chenbo2023-pixel/cat_friend/P0产品设计.md

0. 设计范围说明
本设计聚焦P0主线：用户远程手动"云逗猫"的完整流程，按用户操作时间顺序分为5步：页面元素→云台控制方式→逗猫棒/喇叭触发→反馈确认→异常状态。设计原则：走通一条主线，不做全面铺开设计；简单可靠优先于炫技。

当前实施采用分阶段交付：相机识别、拍照和远程开发已通过，首版只实现Android浏览器经WireGuard观看树莓派视频，再接执行器；iPhone视频接入延期。Rust/MJPEG监控代码与本地测试已完成，Pi真实采集、Android显示及部署仍待验收；代码统一放在现有仓库的 `设备端服务/`。监控首版只提供画面和视频状态，以下保留完整P0交互目标，控制按钮上线需以真实执行器验收为前提。
1. 访问安全方案（前置约束，影响页面设计）
- 当前准入采用两条已验证路径：Android、Mac和树莓派通过WireGuard私网连接；iPhone通过云主机Nginx的HTTPS/mTLS入口访问，需要有效客户端证书。云端应用当前监听本机地址，由Nginx转发，后续设备入口按技术方案配置
- 手机侧配置：Android安装WireGuard并导入密钥；iPhone导入客户端证书。详细部署见《技术方案设计》第12、13、18节
- 效果：通过隧道密钥或客户端证书准入，不需要网页账号密码输入页；公网HTTPS入口由mTLS保护，不能将其描述为完全不监听公网
- 页面形态：采用PWA（渐进式网页应用）形式，首次访问后"添加到主屏幕"，之后点图标直接全屏打开，体验接近原生APP，开发成本仍是一套Web代码
2. 页面元素设计
页面核心元素（P0必须）：
- 视频画面区：实时看猫，页面核心区域，占屏幕最大比例
- 连接状态指示：显示当前连接状态（在线/延迟高/安全模式/离线），与"当前模式"指示合并为一行状态条
- 云台方向控制区：上/下/左/右方向按钮 + 归中按钮
- 逗猫棒触发按钮
- 喇叭触发按钮
明确不做（P2/非目标）：登录账号系统、历史录制回放入口、多语言/主题切换、动画特效
布局线框（示意）：
顶部：状态条（如"● 在线-手动模式"）
中部：视频画面（全宽，占比最大）
底部：左侧云台方向按钮（上下左右+归中），右侧逗猫棒/喇叭按钮
3. 云台控制方式设计
P0实现：方向按钮交互
- 上/下/左/右 4个方向按钮 + 1个"归中"按钮
- 交互方式：点一下转动固定步长（如5°/步），不做长按持续转动，指令离散、协议简单
- 归中按钮：一键回到云台默认中位，可复用ESP32侧安全兜底的归中逻辑
预留扩展口子（不在P0实现，但设计上预留接口）：
- "点击画面聚焦追猫"交互暂不实现，但协议层指令格式设计为"目标绝对角度"（如 {pan: 30°, tilt: 15°}）而非"相对步长"，以便未来点击聚焦、P1自主追踪算法（cat_track_node）可直接复用同一套"设置目标角度"指令接口，无需改动协议和节点架构
4. 逗猫棒/喇叭触发设计
P0交互模式：点一下，执行一次固定动作（不做"按住持续/松手停止"或"切换式播放-暂停"）
- 逗猫棒按钮：点一下 → ESP32执行"摆动N次后自动归位"固定动作序列，N值在ESP32侧配置，不暴露给前端
- 喇叭按钮：点一下 → 播放一段固定音效（如"开罐头声"），播完自动停
- 动作执行期间按钮置灰并显示"执行中..."，防止连续点击导致动作重叠
- 选择理由：固定动作、离散指令、行为可预期，避免"忘记松手/断线导致电机持续转动"的风险
5. 反馈确认设计
三层反馈：
- 指令已发送：按钮点击后立即高亮/置灰+显示"执行中..."，纯前端反馈，零延迟，不依赖网络返回
- 指令已被执行：ESP32执行完成后通过WebSocket回传"执行完成"确认帧，前端按钮恢复可点击状态，短暂显示"✓ 已完成"；同时用户可在视频画面中直接看到实际效果（云台转动/逗猫棒摆动），作为自然的第二层反馈
- 超时兜底：指令发出后若3秒内未收到"执行完成"确认，前端显示"响应超时，请检查网络"，按钮恢复可点击，避免卡在"执行中..."状态
技术前提（需在协议设计阶段落地）：自研TCP协议需预留"执行完成确认帧"类型/字段，用于ESP32向上游回传动作执行结果
6. 异常状态设计
四种状态及页面表现：
状态
触发条件
页面表现
在线-正常
网络与链路正常
状态条绿色"● 在线-手动模式"，按钮正常可点
延迟较高
云端-树莓派链路正常但延迟高（弱网）
状态条黄色"⚠️ 网络延迟较高"，按钮仍可点，提示"响应可能较慢"
安全模式
树莓派-ESP32断连，ESP32看门狗生效自动归中
状态条蓝色"🛡️ 安全模式：装置已自动归中待命"，操作按钮置灰（此时ESP32只听自身看门狗逻辑，不接受外部指令）。设计要点：安全模式需与"断线"用不同颜色/图标区分，让用户清楚感知这是设计好的保护行为而非故障，这是产品核心技术亮点的直接体现
离线/断连
手机断网/云主机不可达/WireGuard断连
状态条红色"⚠️ 连接已断开"，视频画面冻结在最后一帧或显示离线占位图，操作按钮全部置灰
恢复连接后：状态条恢复绿色"● 在线-手动模式"，按钮恢复可点。
7. 待技术方案阶段落地的接口约定
- 云台控制指令：绝对角度格式 {pan, tilt}，供手动按钮/未来点击聚焦/P1自主追踪复用
- 执行完成确认帧：ESP32→上游的动作执行结果回传，用于前端"已完成"反馈
- 网络与准入：复用WireGuard及已部署的HTTPS/mTLS入口，云端应用与设备服务的监听范围按实际部署分别确认
