chenbo2023-pixel/cat_friend/周计划.md

# 猫岗哨周计划：真实硬件接入

## 0. 当前状态与实施原则

云台套件、SG40和树莓派4B 4GB已到货，整机组装、舵机ID/中位和实际UART待验收。树莓派已由Trixie换为Raspberry Pi OS Bookworm 64位（Debian 12，aarch64），用户`cat`；OV5647 CSI摄像头识别和拍照已通过。云端Web/PWA已有上线验收记录，下游尚未接入。

当前优先级：摄像头基础验收（完成）→Android网页监控（代码与本地验证完成，实机待验收）→执行器。12V DC5521转XH2.54替换线仍待到货，用户已暂缓微雪环境配置；UART配置、可选官方程序安装及舵机校准均后移。树莓派疑似因笔记本USB供电受休眠影响而断连；建议独立5V/3A或官方5.1V/3A供电，原因与实际电源更换均未确认。

执行器方案仍为树莓派↔驱动板官方GPIO UART接法；中间USB用于Mac烧录、独立测试和调试。USB启动ESP32/AP不等于舵机12V供电或校准验收。先建立出厂JSON基线，再换自研固件和ROS2桥接；各阶段验收后继续。

逐步命令见[操作指南](硬件组装与树莓派配置操作指南.md)，参数与接口见[硬件参考](微雪云台硬件参考.md)，通信决策见[技术方案设计第4节](技术方案设计.md)。

## 1. 摄像头基础验收（已完成）

- `rpicam-hello --list-cameras`已识别OV5647，`rpicam-still`拍照通过。
- 列出的传感器模式：640×480 / 58.92fps、1296×972 / 46.34fps、1920×1080 / 32.81fps、2592×1944 / 15.63fps；这些不是已实现的视频推流帧率。
- 树莓派WireGuard地址`10.0.0.3`，Mac为`10.0.0.4`；已验证局域网外Mac经隧道SSH到Pi。Pi的`wg-quick@wg0`已active/enabled，重启自动恢复仍待正式测试。

已完成边界：摄像头识别与静态照片，不包括手机实时视频。

## 2. Android网页监控（代码与本地验证完成，实机待验收）

- 已实现独立视频链路，不等待执行器或完整微雪环境安装；尚未部署到Pi。
- 当前按用户决定通过SSH前台手动启动，用完按Ctrl-C停止；运行期间持续采集，关闭网页不停止摄像头。本轮不安装或启用视频自启动，保留模板供未来选择。
- 首版只做Android浏览器，通过已有WireGuard访问树莓派提供的网页和视频；云主机使用已有路由转发，无需新增视频代码，仍消耗视频转发带宽。iPhone视频接入延期。
- 设备端代码统一放在现有仓库 `设备端服务/catfriend-video/`，不创建子仓库或子模块。目录及文件职责见[设备端目录说明](设备端服务/README.md)，运行步骤见[视频服务说明](设备端服务/catfriend-video/README.md)；树莓派建议克隆同一仓库并通过Remote SSH开发，克隆与推送认证待执行。
- 已实现采集源适配器→JPEG帧接口→最新帧分发→网页；支持rpicam适配器与Mac变化的测试输入。IP、端口、路径由TOML配置提供，部署与采集实现解耦。
- 初始配置为MJPEG 640×480、5fps、质量75。Mac测试源短时约5fps，实际Pi性能、手机显示帧率和带宽待验收；后续WebRTC/H264未实施。
- 本地通过9项Rust测试、13项网页逻辑测试及HTTP/模拟相机联调；覆盖JPEG分帧、旧帧清除、观看限额与回收、采集退出/超时恢复、网络写入超时和服务退出。格式与Clippy检查通过。

验收（待执行）：Android浏览器通过WireGuard看到实时画面，先核对手机到Pi视频端口的访问；记录实际分辨率、帧率、端到端延迟及断线恢复结果，并验证Mac测试输入与Pi采集可切换、持续运行、重复手动启停和停止后释放相机与端口。视频实现不应启动云台控制程序；视频开机启动不在本轮范围。

## 3. 组装、舵机ID与中位校准（延期，待验收）

- 先保留出厂固件，按官方教程组装；只连接水平舵机时将ID从1改为2，再断电连接倾斜舵机。
- 关闭扭矩锁，调整摄像头水平朝向正前方，分别设置tilt ID 1、pan ID 2的中位。
- 小幅偏离中位后验证归中，记录固件版本和关节响应。
- 官方T=133中的SPD/ACC=0表示最快；TILT机械参数−45°～90°与官方命令范围−30°～90°分别记录。

验收：两个关节可独立控制，归中正确，运动没有结构或排线干涉。

## 4. 树莓派GPIO UART与可选官方程序验证（延期，未执行）

- Bookworm系统基线已确认，保留当前Pi OS，不按旧安排重刷Ubuntu。官方`ugv_rpi`已克隆到`~/ugv_rpi`，版本`3ae9f203f61bfaaf123ee376f78247d007880b0c`，源码审查已完成；依赖安装、UART配置与自启动均未执行。
- 按官方接线图核对UART引脚、电平和共地。40PIN通信与供电分开确认；独立供电时明确5V连接及隔离方式。
- 检查安装脚本中的UART启用、蓝牙串口分配、内核串口控制台/getty及自启动设置，记录实际UART设备、波特率和帧参数。
- 若选择安装官方程序，再处理适用的Pi 4B v4l2.py兼容项，先手动运行，确认需要后配置自启动并重启复验；不将完整官方环境作为手机监控的前置条件。同一时间只有一个控制程序使用UART。
- 官方主页面默认5000端口，JupyterLab默认8888；AccessPopup热点当前可选。

验收（待执行）：实际GPIO UART JSON控制可用，记录接线、设备与串口配置；若启用官方程序，另验其画面与重启恢复，并记录控制服务的停止/停用方式。源码默认参数见硬件参考，不等于实机配置已生效。

## 5. 固件开发准备与执行器验证（后续待执行）

- 出厂JSON基线通过后，若已安装官方控制服务，先停止并停用，再进行Mac烧录或调试。
- 核对USB桥与GPIO UART的电路关系，避免两端并行驱动同一串口信号；必要时断开UART信号连接。
- 阅读ST3215官方例程和SCServo API，确认实际读角、状态、速度单位及目标到达判据。独立Demo可能覆盖出厂固件，先准备对应恢复资料。
- 查明SG40适用的PWM接口、供电和库配置，再做往复摆动验证；不直接把LED或电机接口当PWM舵机接口。

验收：舵机目标下发与实际读角可用，SG40固定动作能完成。

## 6. 正式驱动板自研固件（后续待执行）

- 复用protocol_test.ino的帧解析和心跳判断，适配实际GPIO UART资源；不直接复用S3的Serial/USBSerial双通道配置。
- handleGimbalCmd/handleActuatorTrigger接真实执行器，补实际读角、机械限位与命令合法性检查；最终限位依据装配和固件核对结果。
- 断心跳执行归中停止；新增并定义0x07进/出安全模式状态帧。
- GPIO UART二进制流不混入调试文本。保留当前AA55/XOR帧格式，连续收发和错误场景需实测。

验收：协议命令使硬件动作，确认帧回报实际结果；不再用目标角度回显代替真实读角。

## 7. ROS2与esp32_bridge_node（后续待执行）

- ROS2发行版尚未决定；结合Bookworm和CSI摄像头基线确定运行环境，不在Pi OS直接照抄Ubuntu的Humble apt安装步骤。
- 跑talker/listener，理解topic发布/订阅，再写桥接节点。
- 订阅/gimbal_target、/actuator_trigger，发送串口帧；解析回包并发布/gimbal_ack、/actuator_ack及安全状态，维护双向心跳。
- UART路径、波特率和帧参数可配置。若容器运行，映射实际GPIO UART设备并配置访问权限，不固定/dev/ttyUSB0。
- 若曾安装官方控制程序，确认已停用；重验200ms心跳周期、1秒超时初始值，以及节点终止/恢复、连续发帧、驱动板与树莓派重启。

验收：命令行发{pan, tilt}→云台运动→回报实际角度；停止心跳触发归中及安全状态，恢复心跳后正确恢复。

## 8. 手机控制闭环（后续待执行）

- 复用已连通的树莓派WireGuard（`10.0.0.3`）；补正式重启自动恢复验收，区分服务active/enabled与重启后实测结果。
- 云端补Pi会话、命令转发和完成/状态广播；实现remote_cmd_node与P0直通cmd_mux_node。
- 前端补设备离线、安全模式禁用控制、重连状态恢复等逻辑。

验收：手机点按钮→真实舵机动作→实际角度回到页面；设备断链、归中、恢复状态能正确展示。

## 9. 记录与后续工作

每阶段记录接线、供电、系统/固件版本、UART设备参数和验收结果。发现实际硬件约束时更新方案，早期设想不作为强制实施要求。

先手机监控，再执行器与控制闭环；官方实时视频不能直接等同猫岗哨视频已接入。近期系统、相机和隧道操作记录见《Mac使用文档.md》。喇叭是否另购、型号和接口待记录，投食机构仍为后续阶段。
