chenbo2023-pixel/cat_friend/微雪云台硬件参考.md

# 猫岗哨：微雪二轴云台硬件参考

## 1. 来源、适用范围与当前状态

本文件整合用户提供的 Waveshare《2-Axis Pan-Tilt Camera Module》Wiki、商品参数页、套件配置清单，以及此前提供的组装配置教程。用于后续硬件问答、接线排查、官方功能验证和自研固件开发。

硬件资料主要为用户粘贴内容，参数标注为厂商描述；在线页面、下位机源码与原理图尚未全面核对。官方上位机`ugv_rpi`已克隆到树莓派`~/ugv_rpi`，版本`3ae9f203f61bfaaf123ee376f78247d007880b0c`，源码审查已完成；软件依赖安装、UART配置与自启动均未执行。源码结论不代替接线与实测验收。

当前状态：树莓派4B 4GB现为Raspberry Pi OS Bookworm 64位（Debian 12，aarch64），用户`cat`，此前Trixie已替换。OV5647识别与拍照已通过；整机组装、舵机ID/中位与实际UART仍待验收。12V替换线待到货，微雪环境配置暂缓；Android监控代码和Mac测试已完成，Pi连续采集与手机显示待验收（见《周计划.md》）。下文官方功能描述不代表本项目已验收。

关联文档：

- [设备清单](设备清单.md)：持有设备与状态。
- [硬件组装与树莓派配置操作指南](硬件组装与树莓派配置操作指南.md)：逐步操作与验收。
- [技术方案设计](技术方案设计.md)：猫岗哨架构与协议，第4节已更新为GPIO UART主链路；第14节保留ESP32-S3的USB测试历史。

## 2. 核心设备与职责

| 组成 | 型号/规格 | 作用 |
|---|---|---|
| 上位机 | 用户自备 Raspberry Pi 4B 4GB；产品也支持 Pi 5 | 摄像头采集、官方 Web 程序；后续猫岗哨 ROS2 与远程命令处理 |
| 驱动板 | General Driver for Robots | 集成 ESP32、串口桥、舵机总线、电机驱动、传感器、供电和扩展接口 |
| ESP32 主控 | 模组 ESP32-WROOM-32；芯片 ESP32-D0WD-V3 | 下位机控制、官方 JSON 指令处理；后续运行自研固件 |
| 水平关节 | ST3215 总线舵机，校准后 ID 2 | PAN：正向右、负向左 |
| 倾斜关节 | ST3215 总线舵机，校准后 ID 1 | TILT：正向上、负向下 |
| 摄像头 | RPi Camera (G)，OV5647，500 万像素，标称 160° 超广角 | 配套 CSI 摄像头，通过排线接树莓派 |
| 补光灯 | 配套 LED 聚光灯，PH2.0 接口，功率 <1.5W | 可见光补光；官方通过 IO5 控制亮度 |
| OLED | 0.91inch，I2C | 显示固件、网络、端口和电压等信息 |
| 主电源 | 配套 12V/5A，DC5521 转 XH2.54 线 | 给驱动板和总线舵机供电 |
| 逗猫棒舵机 | 用户另购 SG40，PWM | 逗猫棒摆动，不属于此套件配置清单 |
| 测试开发板 | 用户原有 ESP32-S3 N16R8 | 协议验证与备用，不是正式驱动板的主控 |

摄像头型号与 CSI 接口已由新资料明确，不再作为“CSI 或 USB 待选”记录；安装时仍核对实物与对应排线。

实际相机基线：`rpicam-hello --list-cameras`成功识别OV5647，`rpicam-still`拍照通过。列出的传感器模式为640×480 / 58.92fps、1296×972 / 46.34fps、1920×1080 / 32.81fps、2592×1944 / 15.63fps；不是已达到的推流帧率。Rust/MJPEG代码已实现，初始配置为640×480、5fps，Mac测试输入已验证，Pi真实性能和手机显示尚未验收，WebRTC/H264后续方案未实施。

## 3. 运动与反馈参数

| 项目 | 厂商描述 | 使用时的边界 |
|---|---|---|
| 自由度 | 2 | 水平、倾斜两轴 |
| PAN 机械范围 | −180°～180°，总范围 360° | 不能据此认定支持无限连续旋转；装配和排线也影响可用范围 |
| TILT 机械范围 | −45°～90°，总范围 135° | 官方 T=133/134 指令描述另写 −30°～90° |
| 驱动器旋转速度 | 40rpm | Wiki 的 `40prm` 与商品页 `40rpm` 对照，按 rpm 记录；指令速度字段换算尚未提供 |
| 堵转扭矩 | 30kg·cm @12V | 是堵转参数，不是持续工作扭矩或可直接换算成载重的数值 |
| 编码器 | 12 位、360°磁编码器 | 4096 个编码级，名义分辨率约 0.088°；不等于整机实际定位精度 |
| 重量 | 441g | 厂商产品标称值，未确认是否包含各附件或用户自备树莓派 |

厂商列举可反馈：驱动器状态、关节角度、旋转速度、负载、电压、电流、温度、工作模式。具体读取 API、单位、回包与完成判据仍需查源码。

ST3215 自身完成位置闭环；ESP32 负责目标下发、反馈读取和上层保护。读取到某次角度或收到命令确认，都不能单独证明已经到达目标位置。

官方调试时按对应命令文档的角度范围操作。自研固件的最终机械限位要结合装配实测确认，不因本次资料整理直接改成另一组数值。

## 4. 供电、通信与接口边界

### 4.1 供电

- 整套产品标称 12V，配套电源 12V/5A。
- 驱动板 XH2.54 输入范围标为 DC 7～12.6V，输入直接用于总线舵机和电机供电。该板级范围不代表整套产品在所有输入电压下性能相同。
- 板上 DC-DC 产生 5V，可为树莓派等上位机供电；资料未给出可用输出电流及全部供电路径。
- USB 用于 ESP32 通信与烧录，不能据此把它当作舵机主电源。
- 12V DC5521转XH2.54替换线仍待到货。USB可启动ESP32/AP，不证明舵机12V供电正常或ID/中位校准成功。
- 最近确认的树莓派供电方式为笔记本USB，疑似受笔记本休眠影响而断连；原因未确认。建议独立5V/3A或官方5.1V/3A电源，实际更换未确认。
- GPIO UART与供电方式分别确认。开发期树莓派独立供电时，先核对40PIN中的5V连接并确认隔离方式；如果完整叠接已连接供电引脚，不能默认与独立电源并用。若由驱动板供电，先确认板载5V能力与路径。

### 4.2 三段通信

| 链路 | 官方资料/项目状态 | 需要区分的内容 |
|---|---|---|
| 树莓派 ↔ ESP32 | 当前整机方案采用官方GPIO UART接法 | 先出厂JSON验证，之后继续用UART承载自研协议 |
| Mac ↔ ESP32 | 中间 USB 接口，经 CP2102 串口桥 | 用于烧录、独立串口测试与调试 |
| ESP32 ↔ ST3215 | TTL 舵机总线，按 ID 区分两个舵机 | 与上位机串口是不同链路；不是 PWM 接口 |

选择依据：当前硬件通过40PIN集成树莓派，官方例程使用GPIO UART。早期USB设想不约束实施；先沿用官方接线建立基线，验证稳定后继续用于猫岗哨。

官方 FAQ 解释禁用 Pi 蓝牙是为了 GPIO UART：Pi 4 默认串口分配涉及蓝牙与 mini UART。按安装脚本、系统版本和实际UART分配确认配置；同时启用串口硬件，关闭该UART的内核串口控制台和登录getty占用。

记录实际UART设备路径、波特率及帧参数，不固定使用/dev/ttyUSB0或猜测/dev/ttyAMA编号。官方程序、测试脚本和自研bridge轮流使用控制链路；迁移时停止并停用官方控制自启动服务。Mac烧录或调试前停止树莓派控制，并核对USB桥与GPIO UART是否共用ESP32信号，必要时断开UART信号连接。

已核对的Pi 4源码基线：上述版本`app.py`使用`/dev/serial0`、115200波特率，下发JSON并追加换行；应用启动会发送T=133、X/Y均为0的归零角度命令。因此启动官方应用也可能触发运动，须先确认供电、校准与结构安全。这是源码行为；配置后实际设备映射、接线与UART收发尚未测试。

正式驱动板有 USB 与 LADAR 两个 Type-C 数据口。USB 是 ESP32 通信/下载口，LADAR 是雷达数据口；它们不是 ESP32-S3 上可分别用于协议和 Native USB 调试的两条 ESP32 通道。GPIO UART二进制协议流不混调试文本，安全状态使用计划中的0x07帧；是否能另设独立USB日志通道需核对UART资源和原理图。

### 4.3 板载资源索引

编号对应用户提供的官方接口图；接线仍需对照实物丝印与原理图。

| 编号 | 资源 | 用途 |
|---:|---|---|
| 1 | ESP32-WROOM-32 | 主控，可用 Arduino IDE 开发 |
| 2 | IPEX1 Wi-Fi 接口 | 外接天线 |
| 3 | 激光雷达接口 | 雷达转接 |
| 4 | I2C 外设扩展 | OLED 或其他 I2C 传感器 |
| 5 | EN 按键 | ESP32 复位 |
| 6 | BOOT 按键 | 配合上电/复位进入下载模式 |
| 7 | DC-DC 5V 电路 | 上位机供电 |
| 8 | Type-C LADAR | 雷达数据 |
| 9 | Type-C USB | ESP32 串口通信与固件下载 |
| 10 | XH2.54 输入 | DC 7～12.6V 板级供电 |
| 11 | INA219 | 电压、电流监测 |
| 12 | 电源开关 | 控制外部供电 |
| 13 | ST3215 接口 | 总线舵机 |
| 14 | PH2.0 6P，B 组 | 带编码器电机 |
| 15 | PH2.0 6P，A 组 | 带编码器电机 |
| 16 | PH2.0 2P，A 组 | 无编码器电机输出；此产品用于 LED |
| 17 | PH2.0 2P，B 组 | 无编码器电机输出 |
| 18 | AK09918C | 三轴电子罗盘 |
| 19 | QMI8658 | 六轴运动传感器 |
| 20 | TB6612FNG | 电机驱动 |
| 21 | 总线舵机控制电路 | 多舵机通信与反馈 |
| 22 | 板载 SD 卡槽 | 可用于日志、Wi-Fi 配置；与树莓派系统卡不同 |
| 23 | 40PIN 接口 | 对接上位机 |
| 24 | 40PIN 扩展 | 引出上位机引脚 |
| 25 | CP2102 | 雷达串口转 USB |
| 26 | CP2102 | ESP32 串口转 USB |
| 27 | 自动下载电路 | 正常上传时无需手动操作 EN/BOOT |

该接口表没有给出 PWM 舵机接口、具体 GPIO 或 40PIN 引脚定义。SG40 接法和电源规格仍需查对应驱动板教程/原理图，不能把 LED 或电机接口当作 PWM 舵机接口。

## 5. 官方程序、网络入口与 OLED

### 5.1 两套入口

| 所属设备/功能 | 网络入口 | 地址 |
|---|---|---|
| ESP32 出厂固件 | PT热点（凭据不在本文记录） | `http://192.168.4.1` |
| 树莓派 AccessPopup 热点 | AccessPopup热点（凭据不在本文记录） | 默认 `http://192.168.50.5:5000` |
| 树莓派接家庭 Wi-Fi 或有线网络 | 使用当前局域网地址 | `http://树莓派IP:5000` |
| 树莓派 JupyterLab | 与上位机页面使用相同网络地址 | `http://树莓派IP:8888` |

5000/8888 是本次资料给出的官方默认端口，实际以配置和启动日志为准。AccessPopup 仅在安装并配置后适用；当前自刷 Lite 系统不能假定已经具备这些服务。

当前自刷系统用户为`cat`，本文不记录登录密码或私钥。官方教程按局域网访问描述页面；项目Pi（`10.0.0.3`）与Mac（`10.0.0.4`）WireGuard已连通，局域网外Mac经隧道SSH到Pi已验证。Pi的`wg-quick@wg0`已active/enabled，但重启自动恢复未正式测试；手机视频与控制仍需猫岗哨接入，不能以SSH连通代替验收。

### 5.2 OLED 两种显示阶段

- ESP32 独立运行：开机版本 `PT CAM Version:0.9`，之后显示 AP 热点名、ST 状态/IP、MAC、电源电压。
- 树莓派主程序运行后：E 为网口 IP，W 为无线 IP，F/J 为主页面与 JupyterLab 端口，最后一行显示 AP 状态或 STA 信号强度及运行时间。

因此 OLED 内容不同可能是程序运行阶段不同，不能仅凭显示了网络信息就推断固件异常。

### 5.3 网络管理命令备查

以下仅记录官方命令，不在本次整理中执行：

- AccessPopup 安装菜单：`1` 安装，`5` 添加/编辑已知 Wi-Fi，`9` 退出。
- `sudo accesspopup -a`：切到 AP。
- `sudo accesspopup`：尝试连接已配置的 Wi-Fi。
- `nmcli connection show`：查看连接配置。
- `sudo nmcli connection delete <connection_name>`：删除指定连接；需替换占位符。
- `sudo raspi-config` → Interface Options → SSH：开启 SSH。

切换模式或删除当前连接会改变访问地址或中断连接，重新按 OLED/IP 访问。当前项目保留“先家庭网络和 SSH 验证，AccessPopup 可选”的安排。

## 6. 官方功能及命令速查

官方上位机基于树莓派，可提供实时画面、缩放、拍照、录像、回看、人脸/运动检测、检测后拍照或录像，以及物体/颜色/手势相关功能。具体算法依赖与当前版本行为需查源码，不能据功能名称认定已实现猫追踪。

ESP32 可脱离树莓派完成云台相关控制；摄像头画面与视觉算法依赖上位机。这些官方功能没有自动接入猫岗哨 PWA，也不能据“实时视频”描述认定使用 WebRTC。

### 6.1 下位机 JSON

以下为出厂固件接口，不是猫岗哨 AA55 二进制协议。刷自研固件后是否保留 JSON 接口需另行决定。

| 用途 | 命令示例 | 字段语义/边界 |
|---|---|---|
| 水平舵机改 ID | `{"T":501,"raw":1,"new":2}` | 只连接水平舵机时执行 |
| 关闭扭矩锁 | `{"T":210,"cmd":0}` | 按官方流程用于手动校准 |
| 设置中位 | `{"T":502,"id":1}` / `{"T":502,"id":2}` | 倾斜 1，水平 2 |
| LED | `{"T":132,"IO4":255,"IO5":255}` | 云台灯使用 IO5；0 关，255 最大 |
| 目标角度 | `{"T":133,"X":0,"Y":0,"SPD":0,"ACC":0}` | X：−180～180°，Y：−30～90°；SPD/ACC 为 0 表示最快，不表示停止 |
| 连续控制 | `{"T":134,"X":45,"Y":45,"SX":300,"SY":300}` | X/Y 同上；SX/SY 为对应轴速度，单位待核对 |
| 停止 | `{"T":135}` | 官方描述用于停止运动；实际保持/制动行为待核对 |
| 自稳 | `{"T":137,"s":0,"y":0}` | s=0 关闭，s=1 开启；使用 IMU 调节竖直轴，y 为目标对地夹角 |
| UI 方向控制 | `{"T":141,"X":0,"Y":0,"SPD":300}` | X/Y 为方向值 −1/0/1，不是角度；0 表示该轴停止 |

资料把 IO4/IO5 输出描述为“设置电压”，同时用于 LED 亮度。记录为官方 0～255 控制值；其实际 PWM/驱动实现需查原理图和代码，不能当作任意精密模拟电压输出。

校准归中示例中的 SPD=0、ACC=0 是最快设置。首次验证先用页面小幅控制，并确认结构与排线无干涉；替代速度数值需查官方单位和范围。

### 6.2 树莓派 Web 页面 Enter Command

这些是页面输入框中的应用命令，不应直接当作 Linux shell 命令执行：

```text
base -c {"T":133,"X":0,"Y":0,"SPD":0,"ACC":0}
base --cmd {"T":133,"X":0,"Y":0,"SPD":0,"ACC":0}
base -r on
base -r off
cv -r [90,120,90] [120,255,200]
cv -s red
track -c 0.023
track -f 0.068
track -s 60
track -a 0.4
```

`base` 转发下位机指令或控制反馈叠加显示；`cv` 调整颜色区间/选择；`track` 调整官方追踪比例、速度和加速度比例。颜色空间、速度单位及算法行为需查源码。官方资料另给出的长参数拼写存在单/双连字符不一致，暂保留上述示例供核对。

## 7. 固件恢复与排查

- 官方判据：开机显示 `PT CAM Version:0.9` 就无需按该教程更新；否则检查固件版本。
- 官方恢复工具为 Windows `flash_download_tool_3.9.5.exe`，选择 ESP32、Factory，保持 LockSettings，选 ESP32 的 USB 串口；最高下载波特率标为 921600，完成显示 FINISH。
- 用户开发环境是 Mac，不能直接执行该 exe。后续如在 Mac 恢复，需先取得官方固件包及其烧录地址/配置，再确定工具与完整参数；本文不猜测 flash 偏移。
- 无串口：先确认接编号 9 的 USB、使用数据线，再检查 CP2102 识别。官方设备管理器说明适用于 Windows；Mac 看对应串口设备。
- 卡在 Connecting：官方建议重新插拔后，在上传连接阶段按住 BOOT，按 EN 约一秒后松开 EN，再松开 BOOT。

刷写 ESP32 固件、设置舵机 ID/中位、烧录树莓派系统是不同操作。官方“恢复出厂程序”是否同时重置舵机内部参数，资料没有明确，不能默认它会恢复舵机校准。

## 8. 套件附件清单

以下按用户提供的商品配置记录，数量未逐件开箱核验。树莓派由用户另购，套件不包含树莓派 4B。

| 分组 | 配置 |
|---|---|
| 核心电子件 | General Driver for Robots ×1；ST3215（含线材和螺丝）×2；RPi Camera (G)（含排线）×1；0.91inch OLED ×1；LED 聚光灯 PH2.0 公头 ×1 |
| 结构与安装 | 轴承定位片 ×1；舵机型材底座（2PCS）×1；机器人云台套件（3PCS）×1；轻量化底座（2PCS）×1；平面推力球轴承 ×1；5.3cm 透明螺丝吸盘 ×5；鱼骨导轨及小扳手 ×1；硅胶脚垫 ×8；螺丝包 ×1 |
| 摄像头排线 | 15PIN 异向约 600mm FFC ×1；15PIN 异向黑色约 400mm FFC ×1；Pi5-Camera-Cable-500mm ×1 |
| 其他连接线 | 舵机 3PIN 异向约 300mm ×2；DC5521 转 XH2.54 约 15cm ×1；PH2.0 双头 4PIN 异向约 20cm ×1；双排杜邦线 2×5PIN 同向约 9cm ×1；USB Type-A 转 Type-C 约 1m ×1 |
| 天线 | 2.4G 小辣椒天线 ×1；IPEX1 转 SMA 外螺内孔约 17cm ×1 |
| 电源与工具 | 12V/5A 电源 ×1；螺丝刀 ×1；小十字套筒 ×1；小扳手 ×1；Jetson Nano Adapter (C) ×1 |

鱼骨导轨和 1/4 手拧螺丝用于扩展安装。Pi 5 排线与 Jetson 转接件是兼容附件，不意味着当前 Pi 4B 组装必须全部使用；选择排线时对照接口和触点方向。

## 9. 后续需要补齐的证据

- 实物版本、OLED 固件版本、舵机 ID 与归中验收结果。
- 系统与官方仓库版本已记录；待补GPIO UART实际引脚/设备映射、串口参数及串口控制台/蓝牙配置生效后的实测。
- 原理图与下位机 `json_cmd.h`、舵机控制实现：引脚、速度单位、限位、反馈和完成判据。
- 12V替换线到货与供电验收、树莓派独立电源实际更换、板载5V输出能力、40PIN供电路径、PWM舵机接口和SG40兼容参数。
- CSI识别与实拍已通过；待补手机监控实际视频指标、官方视频传输与接入行为验证，以及WireGuard重启自动恢复验收。
- 喇叭是否另购、型号与接口：该套件配置清单不含喇叭，也不含投食机构。

官方提供下位机程序、ESP32 下载工具、上位机程序、镜像、图纸、STEP 模型和驱动板原理图入口。除已知上位机仓库 https://github.com/waveshareteam/ugv_rpi 外，本次粘贴未包含可核对的下载链接。下载时以实际官方链接及对应说明为准。
