chenbo2023-pixel/cat_friend/技术方案设计.md

《猫岗哨》技术方案设计

0. 说明
本文档记录技术架构设计阶段的讨论结论与选择原因，承接《项目计划.md》第4节的接口约定。讨论顺序：节点划分→通信方式→协议帧格式→仲裁逻辑→安全兜底超时阈值，前面的决策是后面细节设计的前提。本文档随讨论进展持续更新，未确认的部分会在末尾列出，不提前定稿。

1. 云主机角色
当前结论：云主机承担 WireGuard 中心、Nginx/mTLS 入口以及已部署的 Rust 网页和 WebSocket 服务（见第18节）。仲裁、追踪和执行器控制留在树莓派/ESP32；网络层转发与应用层消息转发分别处理。
- 云主机的作用：解决"家里树莓派没有公网IP、手机在外面摸不到树莓派"的问题。树莓派和手机都主动连出去（NAT只挡"外面连进来"，不挡"里面连出去"），双方都连到云主机上，云主机在中间转发数据包，双方看起来像在同一个虚拟局域网里。
- 安全验证方式：WireGuard的密钥准入机制。只有配好密钥的设备（手机、树莓派）才能加入这个虚拟网络，云主机本身不需要额外写校验代码，验证工作由WireGuard软件完成。
- 选择原因：沿用既有 WireGuard 和 mTLS 准入机制；云端提供网页、会话和消息中转，设备侧负责控制和保护，避免把本地执行器逻辑放到云端。
- 说明：当前 WireGuard 星形组网中的设备间 IP 流量经过云主机转发，由 WireGuard 和系统路由处理；WebSocket 会话和命令转发由 Rust 服务处理，二者不能混为一层。
- 手机侧组网方式的平台差异（已确认）：Android手机直接安装WireGuard官方APK（应用商店在部分地区搜不到，改用官方发布页 https://download.wireguard.com/android-client/ 侧载安装）成功接入虚拟网络，方案不变。iOS暂未装成（App Store该地区不可用，自行编译签名遇到设备注册/Team ID/Bundle ID配置等多步障碍），iOS侧备选方案：改为云主机对公网监听HTTPS端口+浏览器直连，鉴权改用mTLS客户端证书（云主机自建CA给设备签发证书，装入iOS系统证书库，TLS握手层完成双向认证，不需要登录密码，未出示合法证书者连接直接被拒、看不到任何内容），效果上等价于把WireGuard的密钥准入机制平移到TLS层，无需在手机上装VPN App。树莓派⇄云主机这段仍使用WireGuard，不受影响。**此方案已实施并验证通过**（iPhone Safari已能通过mTLS访问云主机），具体配置见第13节。

2. 树莓派节点划分（ROS2）
P0阶段3个节点：
- `remote_cmd_node`：维护和云主机的WebSocket连接，接收手机发来的按钮指令，翻译成ROS2消息发给`cmd_mux_node`；同时接收执行完成回报，翻译回WebSocket告知前端。
- `cmd_mux_node`：纯仲裁大脑，只订阅/发布ROS2 topic，不接触任何网络协议细节（不摸WebSocket，不摸串口协议）。
- `esp32_bridge_node`：维护和ESP32的串口连接，把仲裁结果翻译成协议字节流发给ESP32，把ESP32回传的确认帧翻译成ROS2消息发给`cmd_mux_node`。

P1追加：
- `cat_track_node`：猫检测/追踪，运算结果发布到topic，供`cmd_mux_node`订阅。加入后`cmd_mux_node`只需多订阅一路输入，其余节点不受影响。

选择原因：
- 项目定位（产品定义v1.md）明确提出"用ROS2做具身智能实践demo"，练习ROS2的多节点协作模式本身是项目目标之一，因此选择让每条通信边界（手机侧、ESP32侧）各自独立成一个"翻译节点"，而不是把网络协议代码直接写进仲裁节点里。
- 好处：`cmd_mux_node`的输入输出接口统一为ROS2 topic，以后协议细节变更（如串口协议改版）或功能扩展（P1加`cat_track_node`）都不需要改动仲裁节点内部逻辑，避免耦合导致返工。

3. 节点间通信方式
结论：所有节点间通信统一使用ROS2 topic（发布/订阅），不使用service（请求/响应）。

选择原因：
- Service适合处理时间短、可预期的请求（如查配置、触发标定），ROS2社区惯例不建议在处理时间不确定或较长的场景使用service（官方建议改用action）。
- 本项目的指令类通信（云台转动、逗猫棒/喇叭触发）执行完成时间不确定（依赖真实机械动作/ESP32执行进度），如果用service会导致调用方长时间挂起等待，且若在ROS2回调中同步调用service容易造成死锁（同一执行器的回调线程互相等待）。
- 若坚持用service模拟"等待执行完成"，必须用异步调用（future+回调），写法复杂度和"下发指令topic+完成回报topic"基本相当，但多一层future管理负担，故不采用。
- 采用"指令下发topic + 执行完成回报topic"的组合，本质是自己实现了一个轻量版的action语义，足够满足P0的3秒超时兜底需求，且更简单。

具体topic设计：

| 边 | Topic | 方向 | 说明 |
|---|---|---|---|
| remote_cmd_node ⇄ cmd_mux_node | `/remote_cmd` | remote_cmd_node → cmd_mux_node | 手机按钮指令下发 |
| | `/action_completed` | cmd_mux_node → remote_cmd_node | 执行完成回报，供WebSocket告知前端"已完成" |
| cmd_mux_node ⇄ esp32_bridge_node | `/gimbal_target` | cmd_mux_node → esp32_bridge_node | 云台目标角度指令 {pan, tilt} |
| | `/actuator_trigger` | cmd_mux_node → esp32_bridge_node | 逗猫棒/喇叭触发指令，带`action_type: WAND / SPEAKER` |
| | `/gimbal_ack` | esp32_bridge_node → cmd_mux_node | 云台角度执行完成确认 |
| | `/actuator_ack` | esp32_bridge_node → cmd_mux_node | 逗猫棒/喇叭执行完成确认，带`action_type` |

设计要点与原因：
- 云台角度指令与逗猫棒/喇叭触发指令拆成两个独立topic（`/gimbal_target`、`/actuator_trigger`），而非合并成一个通用"控制指令"topic。原因：两者频率和性质差异大——云台角度未来P1追踪时会高频连续发送，逗猫棒/喇叭是低频离散触发，拆开后各自消息结构更干净，互不干扰，`esp32_bridge_node`不需要每次先判断消息类型。
- 逗猫棒和喇叭是两个独立硬件执行器，允许并发执行（不强制串行等待），因此`/actuator_trigger`和`/actuator_ack`都带`action_type`字段，用于区分具体是哪个动作触发/完成，`cmd_mux_node`据此分别管理两个按钮的忙/闲状态，互不阻塞。
- 云台角度指令同样设计了`/gimbal_ack`确认回报，与逗猫棒/喇叭对称，保证前端"点击→置灰→等ack→3秒超时兜底"这套反馈规则（P0产品设计.md第5节）能统一套用在所有按钮上，不需要为云台方向按钮单独设计一套不同的反馈逻辑。

4. ESP32与树莓派物理连接
当前结论（依据到货模组资料及用户确认更新）：树莓派与General Driver for Robots驱动板通过官方GPIO UART接法通信，作为整机主通信链路；驱动板中间USB口用于Mac烧录、独立串口测试与调试，LADAR口用于雷达。

选择原因：
- 该模组支持树莓派通过40PIN接口集成，官方上位机例程使用GPIO UART；先沿用官方接线和配置建立硬件基线，再接入猫岗哨，避免因早期设想额外改接USB。
- 树莓派与驱动板紧邻，有线UART适合这段本地通信；实际串口稳定性、心跳阈值仍需整机验证。
- 原USB方案是在硬件资料不完整时的初步构思，Mac与ESP32-S3的USB协议测试是已完成的历史验证，不约束正式整机的连接方式。
- 物理接法与消息协议分开：官方验证阶段使用出厂固件JSON；之后GPIO UART继续承载猫岗哨AA55二进制帧，ROS2 topic和节点职责沿用既有设计。

实施要求：
- 按对应驱动板版本的官方接线图/原理图确认UART信号、引脚、共地及电平；不从USB测试固件推定GPIO UART对应ESP32的Serial/UART编号。
- 树莓派启用GPIO串口硬件，按官方脚本核对蓝牙串口分配，关闭该通信UART上的登录控制台/getty占用。记录实际UART设备节点、波特率和帧参数；不固定使用/dev/ttyUSB0，也不猜测/dev/ttyAMA或/dev/ttyS编号。
- `esp32_bridge_node`串口路径和通信参数可配置；若ROS2在容器中运行，映射实际UART设备并配置访问权限。
- 官方程序与自研bridge不同时占用控制链路。刷写、Mac调试前先停止树莓派侧控制程序，按原理图确认USB桥与GPIO UART是否共用ESP32串口/信号，必要时断开UART信号；不能默认两端可并行驱动。
- GPIO UART选择不同时决定供电方式。开发期树莓派独立供电时先确认40PIN的5V连接，避免未核对的多路供电；合并供电前确认板载5V能力与路径。
- 正式固件在GPIO UART协议流中只发送协议帧，安全状态通过计划中的0x07帧上报，不混入调试文本；是否有独立USB日志通道留待原理图和UART资源确认。

5. 串口协议帧结构（外层）
结论：所有帧类型（心跳帧、云台指令帧、执行器触发帧、执行完成确认帧、紧急停止帧）共用同一套外层帧结构：
```
帧头 | 长度 | 帧类型 | 数据体 | 校验
```
靠"帧类型"字段区分具体是哪种消息，收发两侧只需写一套"找帧头→读长度→切数据体→算校验"的通用解析框架，不必为每种消息重复实现。

数据体内部（第二层）采用固定struct格式，不做字段级TLV（即不给数据体内部每个字段再加类型标签），字段位置和长度在协议文档中写死约定（如云台指令数据体="2字节pan+2字节tilt"）。

选择原因：
- 外层用类型字段区分消息种类，本质已经是TLV（Type-Length-Value）设计思路，通用性和可扩展性由这一层提供。
- 数据体内部是否需要再套一层字段级TLV（如Protobuf、HTTP header那种可扩展标签结构），取决于协议使用场景：字段级TLV的核心价值是"生成方和解析方可能不同步升级时，老代码能跳过不认识的新字段、不崩溃"。而本项目ESP32固件和树莓派节点代码由同一人同步开发、同步刷新部署，不存在双端版本不同步的问题，因此不需要为此支付额外开销。
- 嵌入式设备资源有限（CPU/内存/传输带宽宝贵），固定struct的数据体解析更简单、字节开销更小，是嵌入式私有二进制协议（如CAN总线应用层协议、Modbus等同类场景）的常见做法，比字段级TLV更贴合当前场景。

6. 串口协议字段格式细节
结论：
- 帧头：固定2字节 `AA 55`，用于收方在字节流中定位帧起点。
- 长度字段：1字节（可表示0~255），描述"帧类型+数据体"合计长度。
- 校验：1字节，对"长度字段+帧类型字段+数据体"逐字节做XOR（按位异或），收方重新计算比对，不一致则丢弃整帧。

选择原因：
- 帧头`AA 55`是嵌入式串口协议的常见约定取值，纯属双方约定，无特殊含义，只要求"不易与正常数据混淆"。
- 长度字段：当前各帧类型数据体最大不超过个位数字节（云台指令4字节、触发指令1字节、确认帧约2字节、心跳/紧急停止帧可为0字节），1字节长度字段已足够覆盖，无需预留更大位宽浪费带宽。
- 当前保留已实现并在ESP32-S3上验证的XOR帧格式，便于复用双端解析代码；GPIO UART接线后的误码、抗干扰和连续收发需补验。XOR不能检测所有错误，心跳/ack超时也不能代替数据完整性校验；本次物理连接调整不另改协议字段，机械限位与命令合法性检查仍需在正式固件落实。

7. 帧类型编号分配
| 编号 | 帧类型 | 方向 |
|---|---|---|
| 0x01 | 心跳帧 | 双向（树莓派⇄ESP32定时互发） |
| 0x02 | 云台指令帧 | 树莓派→ESP32 |
| 0x03 | 执行器触发帧 | 树莓派→ESP32 |
| 0x04 | 云台确认帧 | ESP32→树莓派 |
| 0x05 | 执行器确认帧 | ESP32→树莓派 |
| 0x06 | 紧急停止帧 | 树莓派→ESP32 |

编号从0x01开始（不用0x00，避免与"空/未初始化内存"默认值混淆，嵌入式协议常见做法）。

心跳帧选择双向而非单向的原因：ESP32需要能主动判断"上游（树莓派）是否失联"，才能触发自动归中停止（产品定义v1.md核心安全设计），仅自己发心跳出去不够，必须同时接收对方心跳、维护"最后一次收到对方心跳"的时间戳，超时未收到则触发断线兜底逻辑（具体超时阈值留待第9节安全兜底章节确定）。

8. 各帧类型数据体字段定义
- 心跳帧（0x01）：数据体为空（0字节），仅作为周期性存活信号。
- 云台指令帧（0x02）：数据体=4字节，`[pan: int16小端, 单位度, 范围-180~180] [tilt: int16小端, 单位度, 范围-180~180]`。
- 执行器触发帧（0x03）：数据体=1字节`action_type`（`0x01=WAND`逗猫棒，`0x02=SPEAKER`喇叭）。
- 云台确认帧（0x04）：数据体=5字节，`[状态: 1字节, 0x00=成功/0x01=失败] [pan: int16小端] [tilt: int16小端]`（pan/tilt为执行后实际角度，编码复用云台指令帧）。带实际角度的原因：P0阶段前端可直接从视频画面确认云台位置，价值有限，但P1自主追踪需要据此做闭环判断，提前预留字段避免后续改协议。
- 执行器确认帧（0x05）：数据体=2字节，`action_type`（1字节，复用0x03定义）+ 执行结果状态（1字节，`0x00=成功`、`0x01=失败`）。不带位置信息，因逗猫棒/喇叭动作没有"位置"概念。
- 紧急停止帧（0x06）：归入P1，P0阶段不设计具体数据体字段。原因：审视现有产品文档（产品定义v1.md、P0产品设计.md），P0页面元素只有方向按钮、逗猫棒按钮、喇叭按钮、归中按钮，没有"紧急停止"这个用户可触发的功能点，当前定义该帧类型缺少对应的产品功能支撑。编号0x06先占位保留，避免以后需要时重新分配编号导致其他帧类型编号变动。

云台指令帧编码方案的选择原因：
- 数值范围选-180°~180°：云台机械结构尚未选型，真实极限角度由ESP32侧机械限位保护兜底（产品定义v1.md已确定），协议层无需绑定具体型号的真实边界，取一个覆盖任意常见二轴云台转动范围的通用值即可。
- 精度选整数度：P0交互是"点一下转动固定步长（如5°/步）"（P0产品设计.md第3节），无亚度级精度需求。
- 字节宽度选int16（2字节，±32767）：远超±180°实际需要，比int8更有余量，避免边界溢出风险，成本（多1字节）可忽略。
- 字节序选小端（Little-Endian）：ESP32与树莓派两端CPU均原生小端存储，采用小端可直接用底层内存操作（如memcpy/to_le_bytes）读写，不需要手动做字节序转换。

9. cmd_mux_node仲裁逻辑（P0阶段）
结论：P0阶段`cmd_mux_node`不实现任何"仲裁"分支逻辑，只做单一指令源的直通转发——收到`/remote_cmd`后转成`/gimbal_target`或`/actuator_trigger`发出去；收到`/gimbal_ack`、`/actuator_ack`后转成`/action_completed`发给`remote_cmd_node`。

选择原因：
- `cmd_mux_node`最初定位是"远程/自主指令仲裁"，但仲裁的前提是"有两个以上指令源需要判断该听谁的"。P0阶段唯一指令源是手动指令（`remote_cmd_node`），不存在冲突需要仲裁，此时写任何优先级分支逻辑都是针对不存在场景的假设设计。
- 真正的仲裁规则（如"用户手动操作时自主追踪要不要让路""追踪中用户突然介入的优先级"）要等P1引入`cat_track_node`、真正出现第二个指令源后，才能看到实际冲突场景，据此设计的规则才准确；提前基于假设设计容易与P1实际实现细节不匹配，导致返工（呼应项目计划.md"细节设计依赖架构决策，顺序反了会返工"的原则）。

10. 三层安全兜底的层次划分
链路拓扑：手机⇄云主机⇄树莓派⇄ESP32。三层划分如下：

- 第1层（ESP32心跳看门狗，最终兜底）：ESP32独立判断"树莓派⇄ESP32"这条心跳线是否超时，不依赖、不区分上游具体是哪一段断（手机断、云主机断、树莓派卡死，在ESP32这一侧看到的现象都是"收不到心跳"）。超时即自动归中停止，是保证装置本身不做危险动作的最后一道防线，纯本地判断，独立于网络状态。
- 第2层（树莓派侧检测）：`esp32_bridge_node`/`remote_cmd_node`检测"云主机⇄树莓派"这段连接状态（如WebSocket是否正常），异常时更新状态供上层（前端）展示。
- 第3层（前端侧检测）：手机侧检测"手机⇄云主机"这段连接状态（如WireGuard/WebSocket是否正常、是否能及时收到视频帧/ack），对应展示P0产品设计.md第6节的四种状态条（在线/延迟高/安全模式/离线）。

选择原因：三层各自独立检测自己负责的那一段链路，不依赖其他层告知，使得任意一段断线时，离故障点最近的那一层能最快发现并响应——ESP32能最快归中停止（不受上游状态污染影响响应速度），树莓派能第一时间感知自己与ESP32/云主机的连接状态，前端能第一时间感知自己与云主机的连接状态，三层共同覆盖手机到ESP32的完整链路。

11. 三层安全兜底各层超时阈值

第1层（ESP32心跳看门狗，树莓派⇄ESP32）：
- 心跳发送周期：200ms（双向互发）。
- 超时判定阈值：1秒（心跳周期的5倍）。ESP32连续1秒未收到心跳，判定上游失联，自动归中停止。
- 选择原因：超时阈值需明显大于心跳周期（业界经验3~5倍），避免正常抖动误判。当前保留200ms/1秒作为GPIO UART整机验证的初始值，实际需在树莓派任务负载、真实舵机动作和重启恢复场景下重验；此前USB测试结果不等同于GPIO UART已验收。

第2层（树莓派侧检测，云主机⇄树莓派）：
- 检测方式：复用WebSocket自带的ping/pong机制测RTT，不自研应用层心跳协议（与树莓派⇄ESP32层不同，那层是硬件层面必须自研，这层已有现成成熟机制可直接复用）。
- "延迟较高"阈值：RTT > 300ms。
- "离线"判定：ping间隔5秒，连续3次无响应（约15秒）判定离线。
- 选择原因：链路走公网+WireGuard，延迟波动通常比本地有线串口大，阈值设置相对宽松，避免正常网络波动导致状态频繁跳变；15秒的离线判定时间是"及时发现断线"与"避免网络抖动误判、反复触发重连流程"之间的权衡。

第3层（前端侧检测，手机⇄云主机）：
- 检测方式：与第2层同款机制——WebSocket ping/pong测RTT，阈值同样为"RTT > 300ms判定延迟较高""5秒间隔连续3次无响应（约15秒）判定离线"，不单独另定新数字。
- 状态来源：前端展示的状态是"手机自己到云主机的连接检测结果"与"树莓派转发过来的下游状态（如ESP32是否已触发看门狗保护）"两者合并得出，非前端单独测得——例如"安全模式"这个状态，前端自己无法测出，必须依赖树莓派主动上报"ESP32心跳超时已触发看门狗保护"。
- 选择原因：第2层和第3层检测的是同一条链路（手机⇄云主机⇄树莓派）的两端，若各自定义不同阈值，容易在两端观测到不一致的网络状况时产生矛盾的状态判断；复用同一套机制和阈值，保证两端标准统一，也节省单独设计一套新机制的成本。

四种状态合并优先级（P0产品设计.md第6节的四种状态条，从高到低）：
1. 离线/断连（手机ping云主机连续15秒无响应）——最高优先级，一旦离线，前端收不到任何下游信息，其他状态判断均无意义。
2. 安全模式（树莓派上报"ESP32心跳超时已触发看门狗保护"）——次高，即使手机⇄云主机链路本身正常，只要下游已进入保护状态就必须显示，确保用户能明确感知"装置已自我保护"而非误认为正常工作中，这是产品核心安全亮点的直接体现。
3. 延迟较高（手机⇄云主机 RTT > 300ms，且无安全模式上报）。
4. 在线-正常（以上条件均不满足）。

12. 云主机WireGuard组网配置记录（已实施）

结论：云主机作为WireGuard中心节点，Android手机、树莓派和Mac作为Peer接入，虚拟网段10.0.0.0/24。树莓派与Mac已配置，外部网络下SSH连接已验证。

文件位置（均在云主机 /etc/wireguard/ 目录下）：
- `server_private.key` / `server_public.key`：云主机自身的WireGuard密钥对
- `phone_private.key` / `phone_public.key`：Android手机的密钥对（由云主机代为生成，私钥需转交手机导入后本机可删除，当前仍留存云主机作为备份）
- `wg0.conf`：云主机WireGuard接口主配置，内容结构为：
  ```ini
  [Interface]
  Address = 10.0.0.1/24
  ListenPort = 51820
  PrivateKey = <server_private.key内容>

  [Peer]
  # Android手机
  PublicKey = <phone_public.key内容>
  AllowedIPs = 10.0.0.2/32
  ```
  已追加树莓派 `10.0.0.3/32` 和 Mac `10.0.0.4/32` 的 Peer。双方私钥各留本机，云主机登记公钥；修改后用 `bash -c 'wg syncconf wg0 <(wg-quick strip wg0)'` 热加载，无需重启整个接口。
- 手机端配置（生成后已转交手机导入，云主机本地未单独存档为文件，需要时可参照下方模板用`phone_private.key`/`server_public.key`重新拼出）：
  ```ini
  [Interface]
  PrivateKey = <phone_private.key内容>
  Address = 10.0.0.2/24
  DNS = 8.8.8.8

  [Peer]
  PublicKey = <server_public.key内容>
  Endpoint = <云主机公网IP>:51820
  AllowedIPs = 10.0.0.0/24
  PersistentKeepalive = 25
  ```

系统级配置：
- `/etc/sysctl.conf`：追加了`net.ipv4.ip_forward = 1`（开机自动生效，永久开启IP转发，使云主机能在Peer之间转发数据包，不需要每次重启后手动执行）
- systemd服务：`systemctl enable wg-quick@wg0`已启用，云主机重启后WireGuard自动拉起

云服务商防火墙：已放行UDP 51820（阿里云控制台"防火墙"设置）。

关键坑点：
- 位于 NAT 后的客户端使用 `PersistentKeepalive = 25` 帮助维持空闲时的 NAT 映射；这不是协议强制要求。云主机从客户端发来的有效 WireGuard 数据学习公网出口 IP 和端口，保活帮助保持回程通道，并不让一台从未主动连接的设备凭空可达。
- 当前地址：云主机 `10.0.0.1`、Android `10.0.0.2`、树莓派 `10.0.0.3`、Mac `10.0.0.4`。树莓派账号 `cat`，配置 `/etc/wireguard/wg0.conf`，私钥 `/etc/wireguard/pi-private.key`；Mac路径和操作见《Mac使用文档》。
- 树莓派 `wg-quick@wg0` 已运行并设置开机启动；SSH 同样已运行并启用。重启后的自动恢复尚未单独完成验收。
- 云主机检查时 `wg0` 正在运行、`wg-quick@wg0` 服务为 inactive/已enabled，说明接口与systemd管理状态不同；当前继续保留接口运行方式。`net.ipv4.ip_forward=1`，检查时 FORWARD 策略为 ACCEPT。
- 曾发生树莓派握手长时间未更新且不可达，Mac和手机握手正常；用户怀疑笔记本休眠停止USB供电，未现场确认。后来树莓派恢复在线，不能把这一故障直接归因为密码或云主机服务。
- `wg-quick up wg0`报"Key is not the correct length or format"：多为配置文件里密钥字段还是占位符（如`<server_private_key>`）未替换成真实密钥内容。
- 云服务商的防火墙/安全组和Linux系统内部端口监听是两层独立机制，`wg show`显示正常不代表公网可达，需同时确认云服务商控制台的放行规则。

13. iOS侧mTLS组网配置记录（已实施，替代WireGuard）

结论：iOS设备改为"云主机监听443端口 + Nginx做mTLS双向证书验证"，不装WireGuard App，浏览器直连。Android/树莓派仍使用WireGuard，本节配置与WireGuard虚拟网段（10.0.0.0/24）互不影响、并行存在。

文件位置（均在云主机 /etc/nginx/mtls/ 目录下）：
- `ca.key`：自建CA私钥，仅云主机保留，不外发，是签发其他证书的信任根，丢失需全部重新签发
- `ca.crt`：CA根证书，已装入iPhone证书库并设置"完全信任"，后续新增其他iOS设备只需重复装这一张CA证书+各自单独签发的客户端证书
- `server.key` / `server.csr` / `server.ext` / `server.crt`：云主机自身的服务器证书，SAN字段填的是云主机公网IP（当前为<云主机公网IP>，若云主机更换IP需重新签发）
- `iphone.key` / `iphone.csr` / `iphone.crt` / `iphone.p12`：iPhone的客户端身份证书，`.p12`是导入iPhone用的打包格式，导出时设置过密码（未记录在文档中，需自行保管）

生成步骤（供后续新增设备/续期证书时参考，无需重复思考流程）：
1. CA：`openssl genrsa -out ca.key 4096` → `openssl req -x509 -new -nodes -key ca.key -sha256 -days 3650 -out ca.crt -subj "/CN=CatFriendCA"`（一次性，除非CA私钥泄露不需重做）
2. 服务器证书：`openssl genrsa -out server.key 2048` → `openssl req -new -key server.key -out server.csr -subj "/CN=<云主机公网IP>"` → 写`server.ext`内容为：
   ```
   subjectAltName = IP:<云主机公网IP>
   extendedKeyUsage = serverAuth
   basicConstraints = CA:FALSE
   ```
   → `openssl x509 -req -in server.csr -CA ca.crt -CAkey ca.key -CAcreateserial -out server.crt -days 820 -sha256 -extfile server.ext`
3. 客户端证书（每台新设备重复本步，CN改成设备标识）：`openssl genrsa -out <设备>.key 2048` → `openssl req -new -key <设备>.key -out <设备>.csr -subj "/CN=<设备标识>"` → `openssl x509 -req -in <设备>.csr -CA ca.crt -CAkey ca.key -CAcreateserial -out <设备>.crt -days 3650 -sha256` → `openssl pkcs12 -export -out <设备>.p12 -inkey <设备>.key -in <设备>.crt -certfile ca.crt`

关键坑点（踩过的坏点，避免重复踩）：
- 服务器证书有效期必须 ≤825天（iOS 13+强制规则，超过此值Safari会判定"不安全"，即使证书链验证已通过；客户端证书不受此限制，可用长效期）。当前server.crt设为820天有效期，到期前需用上面步骤2重新签发（CA、私钥、CSR不变，仅重新签发证书本身）。
- 服务器证书SAN必须填公网IP（不能只填CN，现代TLS校验只认SAN字段），且访问地址必须和SAN完全一致（不能用localhost访问，会报证书不匹配）。
- 生成的`server.ext`需要包含`extendedKeyUsage = serverAuth`，否则curl等工具能忽略此问题连通，但iOS系统级证书校验会拒绝。
- iPhone安装CA证书后，还需额外去"设置→通用→关于本机→证书信任设置"里手动打开该CA的信任开关（安装描述文件本身不会自动启用信任），这一步容易漏。
- Chrome for iOS不支持自动弹窗选择客户端证书，验证mTLS请用Safari测试。

Nginx配置文件位置：`/etc/nginx/sites-available/mtls-test`（软链接至`/etc/nginx/sites-enabled/`），核心配置：
```nginx
server {
    listen 443 ssl;
    server_name _;
    ssl_certificate     /etc/nginx/mtls/server.crt;
    ssl_certificate_key /etc/nginx/mtls/server.key;
    ssl_client_certificate /etc/nginx/mtls/ca.crt;
    ssl_verify_client on;
    location / {
        return 200 "mTLS verified, hello iPhone\n";
        add_header Content-Type text/plain;
    }
}
```
后续接入真实Web服务时，只需把`location /`内的`return`替换为`proxy_pass http://127.0.0.1:<实际服务端口>;`，其余mTLS配置保持不变。

云服务商防火墙：已放行TCP 443（阿里云控制台"防火墙"设置，与WireGuard UDP 51820为两条独立规则）。

14. 串口协议验证记录（已实施）

结论：第5~11节定义的串口协议已在真实硬件上验证通过——帧头识别/长度解析/XOR校验双端一致；云台指令帧(0x02)→云台确认帧(0x04)、执行器触发帧(0x03)→执行器确认帧(0x05)往返正常（含int16小端负角度编码）；心跳断链约1秒触发安全模式、恢复心跳立即退出并回告，与第11节阈值设计一致。

验证环境：手头闲置的ESP32-S3 N16R8（非正式项目驱动板）+ Mac运行`ESP32固件/protocol_test/test_protocol.py`模拟树莓派侧`esp32_bridge_node`角色（pyserial串口操作，与未来树莓派Linux侧同一套操作模型）。代码位置：`ESP32固件/protocol_test/`。

调试通道分离（ESP32-S3历史验证环境）：
- COM口（板载桥接芯片↔UART0，Arduino的`Serial`对象）：只走纯二进制协议帧，Mac侧设备文件`/dev/cu.usbserial-A5069RR4`
- USB口（片内Native USB CDC，`USBSerial`对象）：只走调试文本（SAFETY_MODE_TRIGGERED等），Mac侧`/dev/cu.usbmodem1201`，无需额外配置
- 选择原因：初版测试固件把协议帧和调试文本混在同一串口，接收端只能靠"0xAA 0x55字节模式猜测"区分文本/帧，存在假同步风险（文本恰好含AA 55会被误切帧）；两口物理分离后接收端无需猜测，COM口线上100%是协议字节。正式驱动板不具备S3的Native USB双通道条件，当前GPIO UART方案及日志要求见第4节。

关键坑点（踩过，避免重复）：
- 文本/二进制混流期间漏改一例：SAFETY_MODE_TRIGGERED仍走COM口，混入二进制流的文本字节因恰好不含0xAA被解析器静默丢弃——测试"看起来通过"但预期事件实际没发生。教训：验证要逐项核对预期事件是否出现，不能只看没报错。
- macOS串口设备文件独占：Arduino IDE串口监视器开着时，Python脚本打开同一设备文件报Resource busy，同一端口两头只能留一个。

未覆盖（到真实硬件/树莓派后补验）：
- 确认帧里的角度是假值（指令角度原样回传），未验证ST3215真实读角
- 超时阈值仅在USB直连低延迟环境验证，树莓派跑ROS2后需重新确认
- 未做连续高压发帧、ESP32断电重启恢复等边界场景

到货后复用路径：先用出厂JSON固件和官方GPIO UART上位机完成硬件验证，再将帧解析状态机和心跳判断逻辑移植到正式驱动板，适配实际UART及调试输出。替换`handleGimbalCmd`/`handleActuatorTrigger`中的假值实现，补真实控制/读角、机械限位、断心跳归中和0x07状态帧；不直接复用S3双通道配置。GPIO UART下重新验证连续收发、真实动作和断电恢复。

15. 待P1阶段设计（P0阶段技术方案设计已闭环）
- 紧急停止帧的产品功能设计与数据体字段定义（P1阶段）。
- cmd_mux_node仲裁逻辑细节（P1阶段：优先级规则、超时判定阈值、模式切换策略，待cat_track_node引入时设计）。
16. 摄像头接口与视频推流基础知识（视频链路启动前调研记录）

说明：本节记录视频链路（摄像头→手机浏览器推流）启动前的领域基础知识，为第17节OS选型与后续视频链路设计提供依据。视频链路此前是P0链路中唯一未设计的大块（第15节"已闭环"仅指控制线）。

16.1 摄像头接口的两种类型（CSI vs USB UVC）
CSI（MIPI CSI-2）：
- 物理形态：裸图像传感器（型号如IMX219/OV5647/IMX708）通过扁平排线（FFC）直连SoC的专用摄像头接收外设（树莓派上为unicam）。Pi 4B的CSI座为15针、约2cm宽，位于HDMI口与音频口之间
- 数据形态：传感器输出原始像素（RAW Bayer，每像素仅单色分量、未合成彩色图像），1080p30约700Mbps级，走专用差分串行通道，不占USB总线
- 处理责任在主机侧：软件经I2C配置传感器（曝光/增益），SoC的ISP（图像信号处理器）做去马赛克/白平衡/坏点校正，这套软件统称摄像头软件栈。树莓派基金会维护的栈为libcamera（底层）+rpicam-apps/picamera2（上层工具）。手机前后置摄像头即此架构：传感器直连SoC，画质与延迟最优
USB UVC：
- 物理形态：模组除传感器外自带控制芯片，对外呈现为标准USB设备类（与HID键盘鼠标、MSC U盘同类），Linux有通用驱动uvcvideo，插上即用，任何发行版行为一致
- 数据形态：模组自行完成采集与ISP处理，经USB总线送已格式化帧（MJPEG/YUV）；USB 2.0实际吞吐约320Mbps，故必须在模组内压缩
关键耦合点：当前已验证的CSI链路使用Pi OS的相机工具和驱动；ROS2二进制来源及依赖需要按具体发行版核对，不能直接把Ubuntu的apt安装步骤套用到Bookworm。保留已验证相机基线，再选择容器或原生方案（见第17节）。

16.2 当前摄像头与组装后验证
- 当前摄像头为RPi Camera (G)，OV5647、500万像素、标称160°超广角，CSI排线接口；系统识别和静态拍照已通过。`rpicam-hello --list-cameras` 检测到 `ov5647 [2592x1944 10-bit GBRG]`，照片通过VS Code查看正常；连续视频、手机观看和实际推流帧率仍未验收。
- 看线：摄像头引出扁平排线→CSI；USB线/USB插头→UVC
- 看丝印：模组印传感器型号（IMX219/OV5647/IMX708等）→CSI；印"USB Camera"或型号含"USB"→UVC
- 软件验证（组装后）：rpicam-hello --list-cameras 列出CSI相机；dmesg | grep -i uvc 显示UVC加载记录
- 组装时核对实物型号、排线与触点方向，记录系统识别及实拍结果，作为第17节ROS2运行环境定稿的输入。

16.3 视频流从树莓派到手机的三条路径
前置知识：WebRTC媒体面=两端直连的UDP流（DTLS-SRTP加密），不经过任何HTTP服务器；建立前需双方各自探明候选地址（本机/经STUN查询的公网映射/TURN分配）→经信令通道交换→ICE逐对探测连通性。WHEP为信令的极简HTTP标准化版本（一个POST交换SDP，验证期无需自写信令中转）。
- 路径1 P2P打洞直连：双方向STUN服务器查询自己"在公网上看起来的地址"，互相往对方映射地址发UDP探测包，在NAT上凿出双向映射。成败取决于两侧NAT行为：家宽路由器常见宽松型（出站建立映射后允许入站到该映射端口），蜂窝网CGNAT常见对称型（每个目标对应不同映射端口且过滤严格），任一侧为对称型基本打不通。命中时延迟最低（一跳直达）、云主机零带宽消耗。成功率只能实测（家里路由器与运营商的实际行为理论判断不了）
- 路径2 TURN中继：打洞失败时的标准退路。双方都主动连出到公网TURN服务器（云主机上跑coturn），媒体流变为手机→云→家两段。代价：云主机轻量套餐的固定带宽（3~5Mbps级）成为画质上限（单路720p H.264约1~2Mbps，单观众勉强够但紧）；多一跳公网转发增加延迟；部署需云控制台放行+系统内配置UDP端口段两层操作
- 路径3 HLS降级：放弃WebRTC，视频在树莓派上切成数秒一段的HTTP分片，经Nginx按普通HTTP分发（走443/mTLS通道）。任何网络环境必通、实现最简单、无NAT问题；代价是分片+缓冲导致秒级延迟，"点转→看画面跟着转"的实时闭环体验差。对应产品定义v1预留的"必要时可降级为普通流"
决策逻辑（D4实测后定，不提前定稿）：手机蜂窝网实测打洞成功率→高则P2P为主（TURN备用）→低则算TURN带宽账→账不平则P0先用HLS上线、P2P留作优化项。

17. 树莓派OS与ROS2运行环境（待官方硬件基线验证后定稿）

背景：第2/3节节点设计基于ROS2但未指定发行版；视频链路启动后，OS选择与摄像头软件栈耦合（16.1关键耦合点），需显式定稿。

| 方案 | 组合 | 摄像头栈 | ROS2 | 主要代价/坑 |
|---|---|---|---|---|
| A | Pi OS + ROS2跑Docker | 原生健康（apt直装libcamera/rpicam工具） | 容器内Ubuntu镜像装Humble | 需学Docker命令（小时级）；ROS2节点发现依赖DDS组播，容器默认bridge网络隔离组播，须加--network host；串口映射使用实测确认的GPIO UART设备路径，配置设备权限 |
| B | Pi OS + ROS2 Jazzy原生 | 原生相机链路已验证 | 社区或源码安装方式待验证，不能仅凭Debian基底假定官方apt二进制可用 | 依赖来源、Pi4资源占用和与Humble的兼容性仍需核对 |
| C | Ubuntu 22.04 + ROS2 Humble原生 | CSI摄像头需自拼GStreamer+libcamera链路（Ubuntu 22.04无rpicam-apps包，编译与版本组合坑多，Linux新手易耗时） | 官方平台、资料最多 | 仅当摄像头为USB UVC时，摄像头侧代价消失 |

Docker要点（方案A）：容器与宿主共享同一个内核运行，摄像头/串口等设备节点可用--device映射进容器使用；两个生态（Pi基金会摄像头栈/Ubuntu系ROS2）各取所需、互不污染。

结论矩阵：摄像头为CSI→方案A或B（倾向A：对控制/视频两条线均为最小阻力路径，Docker同时隔离ROS2依赖噪音）；摄像头为USB UVC→方案C重新为优选。
当前状态：树莓派4B已从Trixie更换为Raspberry Pi OS Bookworm 64位（Debian12、aarch64），账号cat。WireGuard、SSH、VS Code默认连接、OV5647识别和拍照通过。12V转接线待补发，微雪环境和UART配置暂缓，先推进独立手机监控设计。ROS2发行版及容器/原生方式尚未定稿；监控首版不以ROS2作为前置依赖。
18. 云端Web服务（已实施，M1~M3真机验收通过）

说明：本节记录"手机⇄云主机"通路的建设结果：技术选型、消息schema定稿（承接第7/8节串口帧设计）、部署形态与验证记录。代码位置：云端服务/catfriend-web/。开发顺序采用两段式：Mac本机验证→云主机部署→iPhone真机验收。

18.1 服务设计与技术栈
结论：Rust + axum，单二进制部署在云主机上。
- 职责边界：提供网页、WebSocket会话和消息中转；WireGuard负责网络层转发与准入。执行器仲裁仍在树莓派cmd_mux_node，实际Pi应用接入和动作回执待实现
- 模块划分：hub.rs（会话注册表：phone会话登记/消息下发）+ ws.rs（会话生命周期：读循环解析+写任务串行化出站）+ messages.rs（消息schema）+ state.rs + main.rs
- 监听地址：127.0.0.1:8080——公网唯一入口是Nginx 443/mTLS的proxy_pass，本进程不直接暴露公网，服务内零鉴权代码（准入完全由mTLS层完成）；树莓派接入后追加监听WireGuard网卡10.0.0.1:8080（隧道内直连，隧道即鉴权，无需TLS）
- 选择原因：axum内置WebSocket、tokio生态、tower-http静态文件，一套依赖全齐；Rust是本人主场；2C2G服务器上单二进制+低内存占用合适。备选Node.js（WS生态资料最多）未采用
- 会话模型：phone会话各持一个mpsc发送端，服务端所有出站消息走"通道→写任务"串行发出（避免并发写同一socket）；不做离线消息暂存（P0无此需求，断线期间指令直接丢弃）
- 无法解析的消息：记warn日志后忽略、不断连——与ESP32帧解析器同款容错策略（两端行为一致，单条坏消息不产生级联断连）

18.2 WebSocket消息schema（定稿）
JSON文本帧，与串口协议帧一一对应；JSON层用可读字符串（面向前端与人工调试），字节层用紧凑编码（面向ESP32）——同一语义在两层各自取最合适的表示，三个翻译节点各翻一层（前端JS↔本schema、remote_cmd_node↔ROS2 topic、esp32_bridge_node↔串口帧）。

| type | 方向 | 字段 | 对应串口帧 |
|---|---|---|---|
| gimbal_cmd | phone→srv | pan: i16, tilt: i16（度，协议层允许±180，机械限位ESP32兜底） | 0x02 |
| actuator_trigger | phone→srv | action: "WAND"\|"SPEAKER" | 0x03 |
| ping | phone→srv | ts: i64（客户端毫秒时间戳） | —（应用层RTT） |
| pong | srv→phone | ts（原样回显） | — |
| action_completed | srv→phone | kind: "gimbal"\|"wand"\|"speaker", status: "ok"\|"fail", pan?, tilt? | 0x04/0x05 |
| device_status | srv→phone | state: "online"\|"offline"\|"safety_mode" | 0x07衍生 |
| error | srv→phone | code: "no_downstream"等, msg | — |

- 心跳与RTT（第11节第3层机制的应用层实现）：客户端5秒发ping，RTT=收到pong时本地时间-ts；>300ms状态条转黄；连续3次无响应（约15秒）判定离线并主动断开走重连（防网络黑洞时onclose不触发）
- 前端维护云台当前角度，收到action_completed时用ack里的真实角度校正（防多次点击后指令角度与物理角度漂移；P1追踪闭环的地基）

18.3 前端（PWA）
- 无框架原生HTML/CSS/JS单页（单用户场景不引构建链）；PWA manifest + iOS专用meta已配置（添加到主屏幕全屏运行）
- P0布局：状态条/视频区占位/方向键+归中/逗猫棒+喇叭
- 状态条三态已实现（在线/延迟高/离线），"安全模式"状态预留，由device_status消息点亮（树莓派接入后）
- 按钮三段反馈（P0产品设计第5节）：立即置灰"执行中"→action_completed恢复"✓已完成"→3秒超时恢复"响应超时"；无下游时收到error即时恢复
- 视频入口现状：`<video muted playsinline>`占位（iOS自动播放前置条件已提前占坑），接入时加RTCPeerConnection+srcObject，信令复用本WebSocket或WHEP（视频线设计时定）

18.4 部署与验证记录
部署形态（云主机上）：
- 代码位置/opt/catfriend-web；专用系统用户catfriend运行；systemd服务catfriend-web（Restart=always，崩溃3秒自拉起），开机自启已启用
- Nginx的mtls-test站点location /已切换为proxy_pass http://127.0.0.1:8080（原echo测试版备份为mtls-test.bak-echo，可随时回退）；mTLS证书配置原样未动
- 服务器为编译Rust加了2G swap（已写入fstab永久生效）；Rust工具链走阿里云rustup镜像+rsproxy crates镜像；代码经tar over ssh传源码、服务器上编译
- 开发期注意：Mac本机dev实例与云端实例互不影响（本机http://localhost:8080调试，云端走mTLS验收）

验证结果：
- 本机(Mac)：静态页200、WS握手、ping→pong回显、gimbal_cmd/actuator_trigger→no_downstream错误回包、坏消息忽略不断连、断线会话清理——node脚本冒烟测试全过
- 云主机：持客户端证书HTTPS 200返回应用页面；无证书400拒绝；WebSocket升级101穿透Nginx；静态资源200
- iPhone Safari真机：页面经mTLS打开、状态条与按钮反馈验收通过（用户确认）

关键坑点（踩过/预防，避免重复）：
- Nginx默认不转发WebSocket升级请求，proxy_pass裸配会导致wss握手失败，必须加：proxy_http_version 1.1 + proxy_set_header Upgrade $http_upgrade + proxy_set_header Connection "upgrade"；另设proxy_read_timeout（长连接读超时，5秒心跳会自然续期）
- 用curl验证mTLS链路时，服务端证书是自建CA签发，curl默认不信任——需--cacert指定ca.crt，否则报"unable to get local issuer certificate"（HTTP 000）
- 服务器1.6G内存且无swap，直接cargo build有OOM风险——先加swap再编译

18.5 原云端控制中转路线预留（当前Android直连路线不依赖）

用户已选择Android经WireGuard直接访问树莓派，后续Android控制接口也计划放在设备端，云主机继续负责网络转发。以下为原云端中转路线的未实现项，保留供未来iPhone入口或集中管理需要时参考；当前不作为设备端开发前置。已部署 `catfriend-web` 服务未停用。

- hub的pi会话槽位与转发逻辑：gimbal_cmd/actuator_trigger原样转发给pi会话；pi回报action_completed/device_status时广播给所有phone会话
- device_status消息的真实发送方（remote_cmd_node翻译0x07状态帧后上报）
- 服务追加监听10.0.0.1:8080（WireGuard隧道内直连，届时pi侧无需证书）
- action_completed的真实闭环：当前前端走3秒超时兜底路径，ack路径待下游接入后生效

19. 独立监控与环境无关设计（代码及本地验证已完成，实机待验收）

19.1 当前进度与开发顺序

- 摄像头识别、静态拍照和远程开发已通过；已实现独立监控代码并完成Mac本地测试。Pi真实连续采集、Android浏览器实际显示、手动部署和持续运行仍待验收。用户已决定当前通过SSH前台手动启停，暂不安装或启用视频自启动。
- 当前优先让设备作为手机监控使用，暂缓微雪依赖安装、GPIO UART和执行器控制。电源转接线到货后再完成舵机校准和控制验收。
- 用户已确定首版只做Android浏览器观看，通过已有WireGuard访问树莓派；视频网页与服务运行在树莓派。iPhone视频接入延期，已有云端网页和mTLS验收记录仍保留。
- 官方仓库已下载至 `/home/cat/ugv_rpi`，检查commit为 `3ae9f203f61bfaaf123ee376f78247d007880b0c`。脚本检查及未来安装步骤见《硬件组装与树莓派配置操作指南》第5节。

19.2 可复用代码边界

```text
采集适配层 → 统一帧接口 → 视频分发服务 → 手机网页
```

采集适配层承接设备差异：首版已实现树莓派 `rpicam` 持续采集适配器，以及Mac上可运行、带变化序号的测试输入；真实rpicam运行待Pi验收，模拟进程的分块输出、退出重连和无帧超时已测试。未来按需增加USB摄像头、RTSP或经核实的官方视频输出适配器。服务主体负责观看连接、状态和重连，不直接依赖OV5647、设备路径或GPIO。

分辨率、帧率、输入来源、监听地址和端口通过TOML配置指定，使用Rust/tokio/axum实现。提供网页、`/stream.mjpg`、`/snapshot.jpg` 和 `/api/status`；网页源文件编译进程序，修改后需重新构建。rpicam依赖留在采集适配器中，不能将“环境无关”理解为所有硬件都不需驱动。

设备端统一使用现有 `cat_friend` Git仓库，代码放在 `设备端服务/`；用户已选择单仓库，不创建子仓库或子模块。视频项目位于 `设备端服务/catfriend-video/`，采集、分发、HTTP、网页、配置和部署模板分别管理，具体文件职责见[设备端目录说明](设备端服务/README.md)，运行与验收见[视频服务说明](设备端服务/catfriend-video/README.md)。未来UART桥接和ROS2节点作为同级项目按需加入。

Mac使用当前工作区，树莓派建议克隆同一仓库至 `/home/cat/cat_friend`，再通过VS Code Remote SSH直接编辑、构建和运行。Git以提交、推送、拉取同步，两台设备不自动同步文件；树莓派仓库克隆与推送认证尚未执行或验收。

19.3 视频和访问候选

| 内容 | 当前候选 | 状态 |
|---|---|---|
| 首版传输 | MJPEG，手机浏览器连续显示JPEG帧 | 已实现，本地HTTP验证通过，Android实机待验收 |
| 初始参数 | 640×480、5fps、质量75，再按带宽和画面调整 | Mac测试源短时约5fps，Pi性能待实测 |
| 后续视频 | H.264/WebRTC | 后续方向，未实施 |
| Android访问 | 通过已有WireGuard访问树莓派提供的网页和视频接口 | 首版代码已实现；Pi部署、视频端口和显示未验收 |
| iPhone访问 | 后续可复用云主机Nginx HTTPS/mTLS入口转发视频 | 首版范围外；准入入口已具备，视频路由未配置 |

Android首版建议地址为 `http://10.0.0.3:8090/`，监听WireGuard地址，端口最终按占用情况和配置确认。云主机无需新增视频代码，继续使用已有WireGuard路由；视频流仍经云主机转发并消耗带宽。不能把已有隧道连通等同于Android到树莓派视频端口已通过验收。

JPEG帧与H.264编码包的数据形式不同。将传输层与采集层分离，后续按实际格式扩展接口，避免假设MJPEG实现可直接转换成WebRTC。当前验收应包括Android浏览器看到真实画面、断连重连、重复手动启停及停止后释放相机和端口、持续运行；视频开机启动不属于本轮范围。图像质量、延迟、带宽均需实测。视频状态依据采集与观看链路判断，不能用云端WebSocket连通或RTT替代视频健康及端到端延迟。

本地已通过9项Rust单元测试、13项网页逻辑模拟测试、HTTP连续帧/截图/多观众测试及模拟rpicam故障恢复测试；Rust格式与Clippy检查通过。服务共享一次采集，慢观众读取最新帧，故障清空旧图；TCP写入无进展默认10秒超时，退出有截止时间。源帧率及时间戳基于服务收到帧的时间，不是浏览器显示帧率或传感器曝光时刻。

19.4 部署与微雪软件共存

业务代码不负责更换apt源、修改启动配置、禁用蓝牙或创建自启动任务；这些步骤放在设备部署流程中，分别确认。自研项目与 `ugv_rpi` 使用独立目录，视频端口8090，实际部署尚未执行。当前仅通过SSH前台运行 `catfriend-video`，使用结束按Ctrl-C退出；程序运行就持续采集，没有观众仍采集，退出时终止rpicam并关闭观看连接。保留systemd模板供未来使用，本轮不安装、启用或配置视频自启动。

源码独立不能隔离系统升级、驱动或共享Python包的变化。未来使用微雪脚本前要核对其全系统升级、依赖安装、启动任务和网络设置；按需要执行步骤，不将完整脚本作为独立监控的必做前置。明确摄像头所有者，避免官方程序和自研服务同时采集；UART同样维持单一控制者。

19.5 已核实的官方控制接口

检查commit中的Pi4入口为 `/dev/serial0`、115200；发送UTF-8 JSON后追加换行。`app.py` 启动会发送零角度 `T=133` 回中指令，默认模块为0（无模块），云台模块定义为2。源码检查不代表实际UART引脚、供电、校准或舵机动作通过；这些条件仍待验收。
