chenbo2023-pixel/cat_friend/项目计划.md

《猫岗哨》项目计划

0. 说明
本文档记录当前阶段（P0产品设计已完成之后）的推进顺序与硬件采购时机决策，依据是《产品定义v1.md》《P0产品设计.md》中已确定的产品/安全决策。

1. 当前阶段结论
P0架构和接口已有设计，云端Web/PWA与mTLS入口已部署。树莓派Bookworm64、WireGuard、SSH、VS Code远程开发以及OV5647识别和拍照已通过。12V转接线待补发，微雪环境、UART和执行器控制尚未验收，当前先推进独立手机监控，视频协议和具体代码接口仍待定。

2. 已确定 vs 未确定
已确定（产品/安全决策，不依赖硬件型号）：
- 物理链路四层拓扑：手机(Web/PWA) ⇄ 云主机 ⇄ 树莓派 ⇄ ESP32
- ESP32计划职责：下发舵机目标、读取反馈、机械限位与心跳保护；ST3215自身完成位置闭环，正式驱动板自研固件尚未验收
- 树莓派职责：摄像头采集和远程命令处理；后续部署ROS2控制节点，运行环境未定。监控首版可独立于ROS2开发
- 云台控制指令格式：绝对角度 {pan, tilt}，供手动/未来点击聚焦/P1自主追踪复用

已设计、待实机验证：
- 控制节点划分、ROS2 topic和UART上的AA55协议，详见《技术方案设计》
- P0单一指令源直通，未来P1多源仲裁规则仍待确定
- 心跳和执行确认的初始参数；ESP32-S3测试结果不能替代正式驱动板验收

当前待确定：
- 独立监控的采集/帧接口、实现语言、配置格式和部署方式
- MJPEG首版及640×480约5fps参数是否采用，后续H.264/WebRTC路线
- ROS2发行版、容器或原生部署，摄像头与官方软件的共存方式

已到货：树莓派4B 4GB、微雪二轴ST3215云台和自带ESP32的驱动板、OV5647 CSI摄像头、SG40。喇叭型号及是否另购待确认；投食机构仍为后续阶段。硬件持有与验收状态见《设备清单》。

3. 推进顺序
1) 完善独立监控设计，使用设备适配器隔离硬件差异；先在Mac测试，再到树莓派验证
2) 实现手机视频、状态和断连恢复，手动验收后确认自启动；源码和部署配置分离
3) 电源转接线到货后完成校准、UART、反馈及执行器验收；按需要采用官方程序，先检查脚本，不直接复制全量系统环境
4) 适配正式驱动板自研固件及控制节点，集成监控与云台控制
5) P1/P2的追踪、投食等按实际使用结果推进

4. 待技术方案设计阶段产出的接口约定（承接P0产品设计.md第7节）
- 云台控制指令：绝对角度格式 {pan, tilt}
- 执行完成确认帧：ESP32→上游的动作执行结果回传
- 访问准入：Android、Mac和树莓派使用WireGuard；iPhone使用已验证的Nginx HTTPS/mTLS入口。公网入口的认证和云端应用监听范围按《技术方案设计》第13、18节处理
