chenbo2023-pixel/cat_friend/舵机入门学习计划.md

# 舵机入门学习计划

## 背景

本项目（猫岗哨）需要用到两类舵机：
- **总线舵机（ST3215）**：用在二轴云台（pan/tilt），因为协议设计要求"云台确认帧带回实际角度"，只有总线舵机能被外部主动查询实际角度。
- **普通PWM舵机（WP90）**：用在逗猫棒左右摆动，因为逗猫棒的执行器确认帧只需要"成功/失败"，不需要角度反馈，用便宜的PWM舵机即可。

用户是C++/Rust背景、安卓和嵌入式初学者，此前没有动手做过PWM/舵机相关的硬件实操。为避免拿到正式项目硬件（Waveshare云台驱动板）后"从零瞎调"，先用便宜的练习件把两类舵机的原理和调试流程摸熟。

**补充说明**：ST3215这类总线舵机不只是本项目会用到，也是当前具身智能/机器人学习领域的通用硬件之一——Hugging Face开源机械臂项目LeRobot（SO-ARM100/SO-101等桌面机械臂）就是用STS3215搭建的。原因与本项目选它的理由一致：便宜、可读取角度/负载/温度反馈、走串口总线便于多舵机联动。因此这次练习顺带积累的经验，在具身智能方向也是通用的。

## 阶段1：概念阅读（不用买东西）

**学会什么**：
- **PWM**：周期性方波信号，靠脉冲宽度（占空比）表达数值。舵机靠PWM脉宽长短决定转到哪个角度。特点：**单向**，主控只管发，舵机不会回话告诉你它现在转到哪。
- **UART（串口）**：双向、点对点通信，两根线（TX发/RX收）双向说话。本项目里ESP32↔树莓派、ESP32↔总线舵机都用这种方式。
- **I2C/SPI**：一个主机接多个从设备的数字通信协议，本项目暂不涉及，了解即可。

**做什么**：看几篇"PWM原理""UART/I2C/SPI区别"的科普文章/视频，1-2天看懂即可，不用动手。

## 阶段2：动手点灯 + 跑PWM

**买什么**：
- 主控：**不用买新的**，用已有的ESP32-S3 N16R8开发板。
- 一个最便宜的**SG90舵机**（几块钱，任意电商平台，纯练习用，不是项目正式硬件）。

**做什么**：
1. 接线：SG90三根线——信号线接ESP32的一个GPIO，电源线接5V（注意GPIO本身电流带不动舵机，需要独立5V供电，比如ESP32的5V脚或外部USB电源，不能只靠GPIO供电），地线共地。
2. 装Arduino IDE + 舵机库（如`ESP32Servo`），照B站"ESP32 Arduino 舵机控制"教程写代码，让舵机在0°~180°之间转动。
3. 改代码里的角度参数，观察舵机转动幅度变化，理解"占空比对应角度"的映射关系。

**学会什么**：PWM周期、脉宽、占空比参数如何影响舵机转动；Arduino IDE给ESP32刷代码的流程（这个操作流程后续刷Waveshare驱动板时是一样的）。

**对应项目**：这是逗猫棒电机（WP90，PWM舵机）控制原理的练习，正式项目里换成WP90接在Waveshare驱动板的PWM接口上，控制逻辑相同。

## 阶段3：体验总线舵机的"发指令+等回复"

**买什么**：
- 一个**ST3215总线舵机**（约¥15~100，规格不同价格有差异）
- 一块**总线舵机调试板**（如飞特官方**FE-URT-1**转接板，几十块钱）——总线舵机是TTL串口通信，裸线不能直接接电脑，需要这块板做电平转换和USB转接。

**做什么**：
1. 用USB接电脑，装厂商提供的Python SDK或调试软件。
2. 发一个"转到XX角度"的指令，再发一个"读取当前角度"的指令，观察它能真的回传实际角度。

**学会什么**：亲身感受"单向发送"（PWM）与"双向问答"（总线舵机协议）的区别；理解为什么"云台确认帧带实际角度"这个协议设计必须依赖总线舵机才能落地，而逗猫棒只需要成功/失败反馈、用PWM舵机就够。

**对应项目**：这是云台pan/tilt舵机（ST3215）控制原理的练习，提前摸熟协议和SDK用法，正式Waveshare云台套件到手后直接复用经验。

**具身智能关联**：ST3215也是LeRobot（SO-ARM100/SO-101等桌面机械臂）等开源具身智能项目的常用舵机，这里积累的经验具有通用性。

## 阶段4：回到项目正式硬件——Waveshare驱动板

**买什么**：正式项目硬件——**Waveshare 2-Axis Pan-Tilt Camera Module + General Driver for Robots驱动板**（云台，已选定）+ 驱动板配套推荐的**WP90舵机**（逗猫棒）。

**做什么**：跑通驱动板官方Wiki的两个教程——
- Tutorial V: ST3215 Serial Bus Servo Control Demo
- Tutorial VI: PWM Servo Control Demo

确认舵机能转、能读角度反馈。之后在这个Demo基础上，改写成《技术方案设计.md》里定义的自研串口协议（TLV帧、心跳看门狗等）。

**学会什么**：有了阶段2/3的实操经验后，看厂商文档会顺畅很多——已经知道PWM舵机和总线舵机背后在发生什么，只是换成这块板子具体的引脚和库函数。

## 采购清单汇总（按顺序）

| 阶段 | 要买的东西 | 大致花费 | 用途 |
|---|---|---|---|
| 2 | SG90舵机 ×1 | ¥5左右 | 练习PWM，非正式硬件 |
| 3 | ST3215舵机 ×1 + FE-URT-1调试板 | ¥50~150 | 练习总线舵机协议，非正式硬件 |
| 4 | Waveshare云台套件 + WP90舵机 | 云台部分价格见《设备清单.md》，WP90另加几十元 | 正式项目硬件 |
