chenbo2023-pixel/cat_friend/产品定义v1.md

《猫岗哨》产品定义 V1
1. 一句话定位
《猫岗哨》——一个固定式云台追猫互动机器人，让开发者在两个月（弹性）内，用 RTOS/协议栈 + ROS2，做出一个能"看猫、追猫、逗猫、远程控猫"的具身智能实践 demo。
1. 目标用户
- 主用户：开发者自己（日常在家使用、验证技术能力）
- 定位：仅自用，不以"给别人看"为目标，不为此额外投入打磨成本（UI精细化、宣传视频剪辑等均为最低优先级）
1. 核心用户故事
2. 用户在外，打开手机页面，看实时画面，手动转动云台看猫在干嘛，并可远程手动触发逗猫棒摆动+喇叭声音，主动逗猫互动（P0，最高优先级场景）。
3. 猫走进摄像头视野，装置自动检测到猫、云台转向锁定，并自主触发逗猫棒摆动+喇叭声音互动，无需人工干预（P1，第二优先级场景）。
4. 猫玩得开心，装置投喂零食作为奖励（P1/P2，视进度）。
5. 用户未远程操作时，装置自主进入"站岗待机"模式，自动巡视，发现猫即互动，全程自主运行无需人管。
6. 网络断开或上层应用卡顿时，装置不做危险动作（云台乱转/卡死），自动归中并安全停止（三层安全兜底核心亮点）。
7. 用户可回顾"猫咪出没集锦"录制片段（P2）。
8. MVP 范围（P0/P1/P2）
P0（MVP 必须有，不达标=项目不算成功）
- 云台二轴手动远程控制（网页/手机可控云台转动）
- ESP32 侧云台角度闭环 + 机械限位保护
- 自研 TCP 二进制协议（云端/树莓派 → ESP32）
- ESP32 心跳看门狗：断线自动归中停止
- 树莓派摄像头视频远程可看（WebRTC，必要时可降级为普通流）
- cmd_mux_node 远程/自主指令仲裁
- 逗猫互动手段（手动触发）：逗猫棒摆动 + 喇叭声音，均支持"远程手动触发"——用户在网页/APP点按钮即可远程操作装置逗猫（预算充裕，成本低但显著提升互动完整度，是P0的核心验收点之一：人能远程手动"云逗猫"）
P1（尽量做，时间紧可延后，不影响验收）
- 猫检测/追踪（运动检测或颜色追踪起步）→ 云台自动追猫
- 自主逗猫互动（第二优先级，依赖上一条检测/追踪能力）：自主行为状态机（待机巡视→发现猫→追踪→自主触发逗猫棒摆动/喇叭声音→归位），实现"装置自己会逗猫"，区别于P0"人远程手动逗猫"
- 三层断线安全兜底的完整测试（弱网模拟）
- 投食机构（奖励环节）
P2（明确可裁剪，不做也不算失败，且因"仅自用"定位进一步降权）
- 自动录制"猫咪出没集锦"
- 网页端 UI 精细打磨、远程/自主模式切换体验优化（可最简陋能用即可）
1. 非目标（Out of Scope，明确不做）
- 底盘移动/自主导航（本产品是固定式）
- 复杂视觉模型（如深度学习检测猫，MVP 阶段不追求）
- 多猫识别/身份区分
- 多设备/多用户并发控制
1. 验收标准
在家实际运行 ≥3 天，累计触发自主互动 ≥5 次，远程控制成功率高，断网测试中云台均能安全归中，并整理出一份包含协议设计、状态机设计的技术文档 + 一段 demo 视频。
1. 关键约束
- 时间盒：8 周为目标节奏，弹性目标，可延至 9-10 周，不因赶进度牺牲 P0/P1 质量（尤其是自研协议与安全兜底两个核心技术亮点，宁可延期也要充分验证）
- 人力：单人开发
- 硬件预算：不是硬约束，可选贵一些但稳定好用的方案（如成品二轴云台、树莓派5），以减少机械调试和返工成本，把时间省下来打磨感知算法与安全逻辑
1. 待后续打磨的方向（下次讨论重点）
- 猫追踪算法具体实现方案（运动检测/颜色追踪 起步路线）
- 自研TCP协议帧格式具体设计（帧头、心跳帧、紧急停止帧字段定义）
- cmd_mux_node 仲裁逻辑细节（优先级规则、超时判定阈值、模式切换策略）
- ROS2节点关系图与topic/service详细设计
- 三层安全容错的具体超时阈值与恢复策略
