chenbo2023-pixel/cat_friend/设备清单.md

《猫岗哨》设备清单

0. 说明
本文档记录硬件采购与持有状态，采购顺序依据《项目计划.md》第3节。每次采购/到货后更新对应条目状态。
最新补充：硬件已到货；树莓派4B 4GB现运行Raspberry Pi OS Bookworm 64位（Debian 12，aarch64），用户为`cat`，此前Trixie已替换。OV5647识别与拍照已通过；整机组装、舵机ID/中位和实际UART仍待验收。云台套件参数、接口、官方命令及附件详见《微雪云台硬件参考.md》；到货不代表功能验收完成。

1. 现有设备
- ESP32开发板：ESP32-S3 N16R8（16MB Flash / 8MB PSRAM），Wi-Fi + BT
- 舵机/云台：微雪二轴云台套件（驱动板自带ESP32-WROOM-32、ST3215×2），另购SG40 PWM舵机
- 摄像头：套件配套RPi Camera (G)，OV5647，500万像素，标称160°超广角，CSI接口
- 其他：树莓派4B 4GB、已刷系统的SD卡（容量未记录）、套件12V/5A电源、LED补光灯、0.91inch OLED及配套结构/连接附件

2. 目标采购设备（按采购顺序）

第一批（现在即可采购，不依赖架构设计定稿）：
| 设备 | 用途 | 型号/规格 | 状态 |
|---|---|---|---|
| ESP32开发板 | 云台角度闭环控制、心跳看门狗、协议下位机 | ESP32-S3 N16R8 | 已有，本项目改用云台驱动板自带的ESP32-WROOM-32，此块暂闲置/留作备用 |
| 闭环舵机云台（二轴） | pan/tilt 云台机械结构 | Waveshare/微雪《2-Axis Pan-Tilt Camera Module》+ General Driver for Robots驱动板（ESP32-WROOM-32主控，ST3215总线舵机×2，磁编码闭环，PAN±180°/TILT-45°~90°，USB/Type-C接口） | 已到货 |
| 逗猫棒电机 | 逗猫棒摆动执行器 | SG40舵机（PWM） | 已到货 |
| 喇叭 | 逗猫音效播放 | 未记录；云台套件不包含 | 早期记录待采购；用户最新称硬件已到货，但是否另购喇叭及型号仍待确认 |

**ESP32-S3 N16R8 板卡调试信息**（用于串口协议测试`ESP32固件/protocol_test/`，待稍后详细调试确认）：
- 板上有两个物理USB-C口，分别标"USB"和"COM"
- **COM口**：接板载USB转串口桥接芯片（CP2102/CH340类），再接ESP32-S3硬件UART0（GPIO1/3）。目前刷固件、串口协议测试全部走这个口，对应Mac设备文件`/dev/cu.usbserial-A5069RR4`。已验证可正常收发。
- **USB口**：对应ESP32-S3片内Native USB外设（USB Serial/JTAG Controller），不经过外部桥接芯片。**已验证可用**（`ESP32固件/native_usb_test/`，用`USBSerial`对象直接发送，无需额外配置"USB CDC On Boot"），对应Mac设备文件`/dev/cu.usbmodem1201`。
- 结论：COM口（`Serial`对象/UART0）与USB口（`USBSerial`对象/Native USB）是两条独立硬件通道，可用于协议帧（COM口）与调试文本（USB口）物理分离，替代当前测试固件里两者混用一条线、靠字节模式猜测区分的临时做法。

第二批（架构+ESP32协议接口基本定稿后采购）：
| 设备 | 用途 | 型号/规格 | 状态 |
|---|---|---|---|
| 树莓派 | 摄像头采集、后续ROS2节点与协议转发 | 树莓派4B 4GB | Bookworm 64位（Debian 12，aarch64），用户`cat`；ROS2未安装、发行版未定 |
| 摄像头 | 视频采集，后续接猫岗哨视频链路 | 套件配套RPi Camera (G)，OV5647，500万像素，标称160°，CSI排线接口 | `rpicam-hello --list-cameras`识别成功，`rpicam-still`拍照通过；设备端视频代码与Mac测试已完成，Pi连续采集和Android显示待验收 |
| LED补光灯 | 低光环境补光 | 套件配套，<1.5W，官方IO5控制 | 已到货，未验收 |
| OLED | 显示固件、网络、端口、电压等 | 套件配套0.91inch，I2C | 已到货，未验收 |
| 主电源 | 驱动板及总线舵机供电 | 配套12V/5A，DC5521转XH2.54线 | 电源已到货，替换线仍待到货；12V供电与舵机校准未验收；板载5V能力与路径需核对 |

接口备注：当前整机方案采用官方GPIO UART连接树莓派与ESP32，先JSON验证再接自研二进制协议。正式驱动板中间USB经CP2102连接ESP32，用于Mac烧录、独立测试与调试；另一个LADAR Type-C用于雷达。UART引脚、设备节点及参数按实物和源码确认，40PIN通信与供电路径分别核对。机械TILT标称-45°~90°，官方T=133/134命令描述为-30°~90°，详见硬件参考文档。

供电备注：最近确认的供电方式为笔记本USB，疑似受笔记本休眠影响而断连，原因尚未确认；建议独立5V/3A或官方5.1V/3A电源，实际更换未确认。USB可让ESP32启动并提供AP，但不证明舵机已有12V供电或校准成功。因替换线待到货，微雪软件环境配置暂缓，当前先做手机监控视频，再接执行器（顺序见《周计划.md》）。

第三批（P0跑通验收后，不影响主线，可延后）：
| 设备 | 用途 | 型号/规格 | 状态 |
|---|---|---|---|
| 投食机构 | P1/P2 投喂零食奖励 | 待定 | 延后 |

3. 云主机
- 用途：Web服务（WireGuard虚拟网卡绑定）、云台指令转发/中转、WebRTC信令
- 状态：已购买（阿里云轻量应用服务器，2 vCPU/2GiB/40GiB，Ubuntu 22.04），已装好WireGuard并跑通
- 组网进度：云主机⇄Android手机已验证连通（WireGuard）；云主机⇄iOS手机已验证连通（Safari访问成功，使用mTLS客户端证书，非WireGuard）。树莓派`10.0.0.3`与Mac`10.0.0.4`的WireGuard隧道已连通，Mac在局域网外经隧道SSH到树莓派已验证；Pi的`wg-quick@wg0`已active/enabled，重启自动恢复尚未正式测试。近期操作记录见《Mac使用文档.md》，原方案见《技术方案设计.md》第12、13节。
- SSH已切换密钥登录并关闭密码认证
