chenbo2023-pixel/cat_friend/硬件组装与树莓派配置操作指南.md

# 猫岗哨：硬件组装与树莓派配置操作指南

## 当前状态与本次目标

当前树莓派 4B 已从 Trixie 更换为 Raspberry Pi OS Bookworm 64 位，架构 `aarch64`，账号 `cat`。WireGuard、SSH、VS Code 远程连接及 OV5647 识别、拍照均已通过。整机装配、舵机校准和 GPIO UART 控制尚未完成验收；12V 转接线仍待补发。

本指南依据本次讨论和用户提供的 Waveshare《2-Axis Pan-Tilt Camera Module 组装和配置教程》整理。官方程序仓库：https://github.com/waveshareteam/ugv_rpi
后续补充的完整参数、接口及指令已整理到[微雪云台硬件参考](微雪云台硬件参考.md)。当前整机方案采用官方GPIO UART连接树莓派与驱动板；中间USB用于Mac烧录、独立测试与调试。先用官方JSON程序验证，之后GPIO UART继续承载自研二进制协议。

当前先完成Android网页监控，暂缓微雪环境安装和执行器控制。独立Rust/MJPEG服务与Mac本地测试已完成，Pi真实采集、部署和Android显示待验收，运行步骤见[视频服务说明](设备端服务/catfriend-video/README.md)。完整控制基线仍要求两个云台关节可控、归中正确、串口通信和反馈正常。

执行顺序：

**系统与远程连接（已通过）→ 相机识别和拍照（已通过）→ 独立监控（代码和本地测试完成，实机待验收）→ 供电和校准 → 按需配置控制依赖和 UART → 手动验证 → 自启动与重启复验。**

每一阶段通过验收后再继续。保留出厂固件；未来使用官方程序时，按本文的源码检查结果逐项确认安装影响。微雪全量安装脚本不作为监控开发的前置要求。

## 1. 机械组装与初次上电

按官方组装视频安装结构件。新版舵机底座外形有变化，官方说明安装方式不变。

在修改 ID 之前，**不要连接水平舵机与倾斜舵机之间的总线线缆，让驱动板只连接水平舵机**。两个舵机出厂 ID 都是 1，同时连接会导致修改对象不明确。

按官方教程的上电顺序操作：

1. 产品电源开关置于 OFF。
2. 用 USB 数据线连接 Mac 与驱动板中间标为 USB 的接口，以实物及教程标识为准。
3. 接入配套的 12V/5A 电源。
4. 打开电源开关。
5. 检查 OLED 是否显示 `PT CAM Version:0.9`。

当前校准不需要树莓派运行系统。官方初次上电流程是在树莓派未插 SD 卡的状态下操作；如需取下已刷好的卡，先确保树莓派已关机并断电。

如果没有教程所述的版本或控制界面，先确认出厂固件情况，再按官方固件更新教程处理。

USB 的 5V 已能让 ESP32 启动并开启 PT 热点，但不等于总线舵机有正常主电源。用户此前仅用 USB 发送过校准命令；页面接受命令不能证明舵机执行成功，仍需在 12V 供电下按实际动作重新验收。XH2.54 转接线只是转换接口，不改变电压；12V 不可直接接树莓派 USB-C。

验收与记录：

- [ ] 结构安装完成，水平舵机单独连接。
- [ ] 已按 USB → 12V 电源 → 开关的顺序上电。
- [ ] OLED 版本已确认：________。

## 2. 修改水平舵机 ID

手机或电脑连接驱动板热点：

- 热点名：`PT`
- 密码：`12345678`
- 浏览器访问：`http://192.168.4.1`

在页面的 `FEEDBACK INFOMATION` 指令框中发送：

```json
{"T":501,"raw":1,"new":2}
```

这条命令把当前单独连接的水平舵机 ID 从 1 改为 2。倾斜舵机保留 ID 1。

| 关节 | 项目名称 | 校准后 ID |
|---|---|---:|
| 倾斜 | tilt | 1 |
| 水平 | pan | 2 |

验收与记录：

- [ ] 发送修改命令时，总线上只有水平舵机。
- [ ] 已发送修改 ID 命令，页面反馈已检查。

## 3. 连接两个舵机并设置中位

1. 关闭产品电源。
2. 连接水平与倾斜舵机之间的总线线缆。
3. 按前面的上电顺序重新开机，连接 PT 热点并打开控制页面。
4. 发送关闭两个舵机扭矩锁的命令：

```json
{"T":210,"cmd":0}
```

确认扭矩锁关闭后，手动调整云台，使摄像头水平朝向正前方。再分别发送中位设置命令：

```json
{"T":502,"id":1}
```

```json
{"T":502,"id":2}
```

保持运动范围内无障碍，使用方向按钮做小幅运动，分别确认两个关节能响应。偏离中位后，再发送：

```json
{"T":133,"X":0,"Y":0,"SPD":0,"ACC":0}
```

确认两个关节回到刚才设置的正前方。必须先偏离中位再验证；始终停在零位时发送归中命令，不能充分证明校准成功。
官方说明中 `SPD=0`、`ACC=0` 表示最快速度/加速度，不表示停止。首次验证先做小幅运动。机械TILT参数为−45°～90°，但官方 `T=133/134` 指令描述为−30°～90°；用出厂程序时按对应指令范围操作，最终机械限位留待装配实测确认。

如运动或归中异常，重新检查 ID、连接及中位设置，先完成校准再进入树莓派控制。

验收与记录：

- [ ] 水平关节能独立运动。
- [ ] 倾斜关节能独立运动。
- [ ] 偏离中位后，归中命令能使摄像头回到水平朝向正前方。
- [ ] 小幅运动中没有结构干涉。
- [ ] 已关闭产品电源。
- 校准日期及现象：________。

## 4. 确认树莓派系统和摄像头

通过树莓派终端或 SSH 登录。SSH 示例中的用户名和 IP 需替换为自己的实际值：

```bash
ssh 用户名@树莓派IP
```

在树莓派上执行：

```bash
cat /etc/os-release
uname -m
```

检查：

- `VERSION_CODENAME=bookworm`
- 架构输出为 `aarch64`

Lite 表示没有桌面环境，64 位表示架构，二者不能单独证明系统版本是 Bookworm。用户提供的官方教程明确限定其程序基于 Bookworm；若版本不同，先解决系统兼容问题再安装。

Lite 可以用于 SSH 和后台服务开发，是否需要补额外依赖以实际安装脚本和运行结果为准。

### GPIO UART接线与供电核对

按对应板版本的官方接线图确认树莓派与驱动板UART信号的连接、共地、电平和ESP32 UART映射，不直接套用ESP32-S3测试固件的引脚。

GPIO UART接线不意味着已选择供电方案。若树莓派使用独立电源，先核对40PIN的5V连接及隔离方式；若由驱动板供电，核对5V输出能力和完整供电路径。记录实际接法，避免把“完整叠接40PIN”与“独立供电”直接组合使用。

新提供的套件资料明确摄像头为RPi Camera (G)：OV5647、500万像素、标称160°超广角，CSI排线接口。安装时核对实物与排线触点方向，记录识别及实拍结果，作为后续视频链路与ROS2环境选择的输入。

### 已通过的相机基线

`rpicam-hello --list-cameras` 已识别 `ov5647 [2592x1944 10-bit GBRG]`。列出的 640×480、1296×972、1920×1080、2592×1944 是传感器模式，不代表网页推流的实际帧率。

拍照验证已通过，使用：

```bash
mkdir -p ~/cat_friend/camera_test
rpicam-still --nopreview --timeout 2000 --width 2592 --height 1944 -o ~/cat_friend/camera_test/front.jpg
```

通过 VS Code 查看照片确认画面正常。CSI 排线插拔需先关机断电；多个程序应协调摄像头所有权，避免同时打开同一相机。

树莓派曾由笔记本 USB 供电，掉线时云主机上的树莓派握手长时间未更新，用户推测笔记本休眠导致供电停止。独立供电建议使用官方 5.1V/3A 或可靠的 5V/至少3A USB-C 电源；实际是否已更换适配器尚未确认。

验收与记录：

- [x] SSH 可登录，树莓派已接入互联网及 WireGuard。
- [x] 相机识别与拍照通过。
- 系统版本：Bookworm（Debian 12）。
- 架构：`aarch64`。
- 树莓派型号：4B 4GB。
- 摄像头型号及接口：OV5647，CSI。
- GPIO UART信号接法/原理图版本：________。
- 树莓派及驱动板供电路径：________。

### apt 镜像修复记录

Bookworm初次安装WireGuard时，apt下载停顿。检查发现DNS解析正常、没有其他安装进程，`deb.debian.org:80`连接不稳定并超时，临时强制IPv4仍失败。将 `/etc/apt/sources.list` 的Debian源替换为清华HTTPS镜像：

```text
deb https://mirrors.tuna.tsinghua.edu.cn/debian bookworm main contrib non-free non-free-firmware
deb https://mirrors.tuna.tsinghua.edu.cn/debian-security bookworm-security main contrib non-free non-free-firmware
deb https://mirrors.tuna.tsinghua.edu.cn/debian bookworm-updates main contrib non-free non-free-firmware
```

`raspi.list` 中的树莓派官方源保持原样。换源后约8秒下载24.9MB索引，再次apt更新成功，`dpkg --audit`未发现未完成配置。此速度仅为当次观测，不是镜像性能保证；GitHub或VS Code组件下载走不同地址，不能据此判断它们也已恢复。

## 5. 官方软件准备与安装检查

已下载到树莓派 `/home/cat/ugv_rpi`，检查版本为 `3ae9f203f61bfaaf123ee376f78247d007880b0c`。`setup.sh`、`autorun.sh`、主要配置和入口源码已检查；依赖安装、UART 配置、应用自启动均未执行，当前暂停环境配置。

以下命令均在树莓派上执行：

```bash
sudo apt update
sudo apt install -y git
cd ~
git clone https://github.com/waveshareteam/ugv_rpi.git
cd ~/ugv_rpi
```

如果目录已存在，先确认是否为之前下载的仓库，不必重复克隆或覆盖。

先查看仓库说明和脚本，明确安装内容及启动方式：

```bash
ls
less setup.sh
less autorun.sh
```

`less` 中按 `q` 退出。仓库内容可能随官方更新发生变化，以下结论仅对应上述 commit。

| 源码位置 | 实际行为与安装影响 |
|---|---|
| `setup.sh` 参数 `-i/--index` | 切换镜像源，会覆盖 Debian 和 Raspberry Pi 源；不是“安装”开关 |
| 启动配置 | 删除 UART 控制台参数、启用 UART0、追加 `disable-bt`，禁用 `hciuart` 和蓝牙服务 |
| apt 阶段 | 包含 `apt upgrade -y` 全系统升级，并安装网络、音频等工具 |
| Python 环境 | sudo 下创建 venv；实际 `$USER=root`，pip 和 `dialout` 操作可能落到 root |
| `requirements.txt` | 350 行，混有应用、桌面、系统绑定和开发工具；部分版本固定项需调整，不能直接当精简运行依赖 |
| 系统文件 | 复制音频配置及 OAK udev 规则，并重载规则 |
| 失败处理 | 未使用可靠的失败中止机制，打印 `Setup completed` 不证明所有步骤成功 |
| `autorun.sh` | 为 `cat` 用户添加应用和 Jupyter 的 `@reboot` crontab，并清空 Jupyter token/password |

未来按需安装时，先区分系统相机绑定与应用依赖，使用 `cat` 用户创建 `--system-site-packages` 虚拟环境。Picamera2/libcamera 优先使用 apt 提供的绑定，避免 pip 覆盖系统相机栈；多个 pip OpenCV 分发包都提供 `cv2`，应选择一致的实现。不要仅为视频服务复现整份官方桌面环境。

原脚本会改变共享系统，可能影响已有监控服务。逐项确认后执行必要步骤，分别验证依赖导入、相机、串口和网络。自研代码放在独立项目中，部署步骤与业务代码分离。

验收与记录：

- [x] 已查看安装与启动脚本。
- [ ] 安装完成，成功提示已确认。
- 检查版本：`3ae9f203f61bfaaf123ee376f78247d007880b0c`；安装尚未执行。

## 6. 树莓派 4B 的 v4l2.py 兼容处理

官方教程要求树莓派 4B 删除虚拟环境和用户目录中的特定 `v4l2.py`，让程序使用系统范围内的版本。树莓派 5 按该教程跳过此步骤。

先确认创建的虚拟环境及版本目录：

```bash
ls -d ~/ugv_rpi/ugv-env/lib/python*
```

如果实际为 Python 3.11，检查两个指定文件：

```bash
ls -l ~/ugv_rpi/ugv-env/lib/python3.11/site-packages/v4l2.py
ls -l ~/.local/lib/python3.11/site-packages/v4l2.py
```

仅对实际存在且路径确认正确的文件，分别执行：

```bash
sudo rm ~/ugv_rpi/ugv-env/lib/python3.11/site-packages/v4l2.py
```

```bash
sudo rm ~/.local/lib/python3.11/site-packages/v4l2.py
```

某个文件不存在时跳过该文件。若虚拟环境不是 Python 3.11，先确认实际路径与官方兼容说明是否仍适用。保留系统目录中的 `v4l2.py`，因为它正是官方希望程序使用的版本。

验收与记录：

- [ ] 已确认树莓派型号及实际 Python 环境。
- [ ] 两个指定文件已检查，适用项已处理。
- 处理结果：________。

## 7. 手动验证官方程序，再配置自启动

运行前确认GPIO串口硬件已启用、所用UART没有被内核串口控制台或serial-getty占用，并核对官方程序的UART设备、波特率与帧参数。不能直接把旧计划中的/dev/ttyUSB0替换成猜测的/dev/ttyAMA编号。

如系统存在/dev/serial0，可只读检查它的实际指向：

```bash
ls -l /dev/serial0
```

已检查版本的 `app.py` 对 Pi 4 使用 `/dev/serial0`、115200 波特率；`base_ctrl.py` 通过串口发送 UTF-8 JSON 并追加 `\n`。检查时树莓派尚无 `/dev/serial0`，实际引脚、映射与整机反馈仍待配置和验收。

依赖、串口、供电、校准条件满足后，已确认的手动入口为：

```bash
cd ~/ugv_rpi
./ugv-env/bin/python app.py
```

首次运行会发送 `T=133` 的零角度回中指令，并配置下位机模块等参数。默认 `module_type=0` 为无模块，云台模块应使用官方定义的值 `2`；完整机器人类型设置须按套件核对，不把通用 UGV Rover 默认值直接作为最终云台配置。

官方应用和自研监控程序不能同时占用摄像头；控制服务同样需要单一 UART 使用者。检查已有进程及自启动来源后，再手动运行。

本次官方资料给出的主程序默认端口为5000，JupyterLab为8888；以实际配置和启动日志为准。接家庭网络时访问 `http://树莓派IP:5000`。若安装并启用了AccessPopup，默认热点模式主页面为 `http://192.168.50.5:5000`。

注意两个入口的区别：

| 入口 | 所属设备 | 当前用途 |
|---|---|---|
| `http://192.168.4.1` | ESP32 驱动板的 PT 热点 | 出厂固件控制、ID 与中位校准 |
| `http://树莓派IP:5000` | 树莓派 | 官方上位机页面、摄像头与控制功能 |
| `http://树莓派IP:8888` | 树莓派 | 官方JupyterLab |

不要把 ESP32 页面地址直接当作树莓派视频页面地址。

先确认摄像头有画面，两个关节可控且归中正确。结束手动运行的实例后，再选择需要的自启动机制。以下为官方方式，仅供未来确认后使用，不是当前待执行步骤：

```bash
cd ~/ugv_rpi
./autorun.sh
```

该脚本同时配置 Jupyter，不能只理解为应用自启动。若采用它，迁移自研服务时应检查 `crontab -l` 中对应任务；如果另建 systemd 服务，也应避免与这些任务重复运行。

完成后重启：

```bash
sudo reboot
```

重启会断开 SSH。树莓派重新启动后，再连接并复验。

验收与记录：

- [ ] 手动运行无阻塞性错误。
- [ ] GPIO UART配置已核对，控制台/getty已释放该串口。
- [ ] 同一时间只有一个控制程序使用UART。
- [ ] 树莓派页面能访问，摄像头有画面。
- [ ] 页面可控制水平、倾斜关节并正确归中。
- [ ] 已结束手动实例并配置自启动。
- [ ] 重启后服务自动启动，画面与控制仍正常。
- 树莓派页面地址及端口：________。
- 手动启动命令：________。
- 实际UART设备路径、波特率和帧参数：________。
- 官方控制服务名称及停止/停用方式：________。

## 8. 可选：AccessPopup 开机热点

AccessPopup 用于让树莓派开机自动建立热点，与 ESP32 的 PT 热点不同。
官方默认热点名为 `AccessPopup`，密码 `1234567890`，IP为 `192.168.50.5`；这些配置仅在安装并启用后适用。

当前通过家庭网络和 SSH 开发，先暂缓安装。基础功能验证通过后，如确实需要树莓派热点，再检查脚本和网络配置：

```bash
cd ~/ugv_rpi/AccessPopup
less installconfig.sh
chmod +x installconfig.sh
sudo ./installconfig.sh
```

按官方教程菜单输入 `1` 安装，出现 `Press any key to continue` 后按键，再输入 `9` 退出。

该步骤可能调整网络配置并使 SSH 断开。执行前应具备重新查找地址或通过本地终端访问树莓派的条件；安装后重新验证网络和服务。

## 9. 官方功能通过后的项目衔接

当前可以独立推进监控功能。供电恢复后完成上述执行器验收，再推进猫岗哨控制链路：

1. 交接控制链路：停止官方实例，取消其 crontab 或实际服务中的自启动任务，退出测试脚本。Mac烧录或调试前核对USB桥与GPIO UART是否共用ESP32串口/信号，必要时断开UART信号；不能默认两端可并行发送。
2. 正式驱动板自研固件：适配实际GPIO UART，接入真实舵机控制与读角、机械限位、断心跳归中、`0x07` 安全状态帧。JSON与二进制协议按固件阶段切换，二进制流不混调试文本。
3. 树莓派环境及 ROS2 节点：结合实际系统和摄像头结果确定运行方式，实现串口桥接与远程命令节点。UART路径、波特率和帧参数可配置；容器运行时映射实际设备并配置权限。重验心跳、连续收发和重启恢复。
4. 云端下游接入：补树莓派会话、指令转发、完成回执及设备状态上报。
5. 全链路验收：手机点按钮 → 真实舵机动作 → 实际角度回到页面，与已独立开发的视频链路集成。

视频协议、采集适配层和部署边界见《技术方案设计》第19节。本文只记录已验证结果及后续控制条件；完整微雪安装、自启动、重启恢复和执行器控制仍待验收。
