chenbo2023-pixel/cat_friend/(commit log)

2026-09-21 初始产品、设计、项目文档
2026-09-22 补充技术方案设计文档，更新设备清单
2026-09-29 记录云主机组网配置：WireGuard(Android/树莓派)与mTLS(iOS)方案及踩坑
2026-10-08 硬件到货周计划：组装→官方Demo→协议固件移植→树莓派ROS2桥接；纳入ESP32固件/舵机练习代码，记录串口协议真机验证与设备到货状态
2026-10-10 云端Web服务上线：Rust(axum)转发服务+PWA前端，WebSocket消息schema定稿，mTLS入口链路iPhone真机验收通过(M1~M3)；技术方案设计新增第18节
2026-11-06 新增硬件组装与树莓派配置操作指南
2026-11-10 docs: 更新云台硬件参考及 GPIO UART 接入计划
2026-11-13 docs: 同步树莓派验收及独立监控开发计划
2026-11-13 feat: 实现设备端视频监控与 SSH 手动运行方案
